PaxInstruments/t400-enclosure/graphics/front label/v1/dimensions_t400.pdf

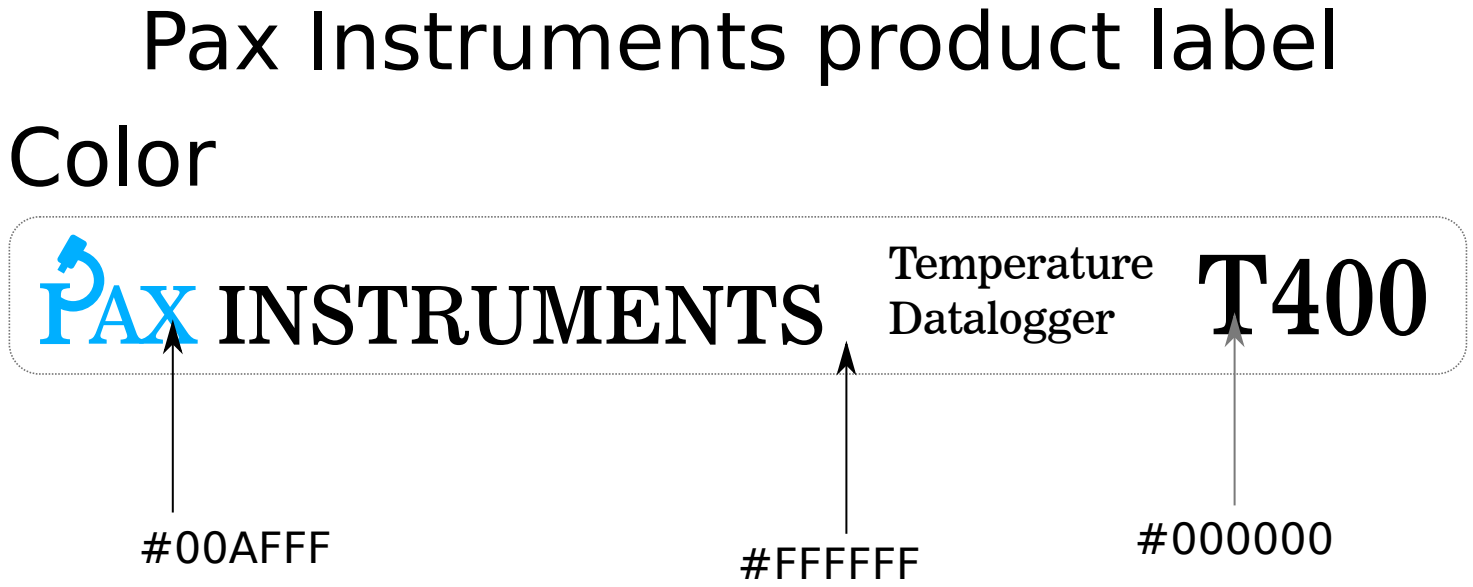
[picture p1: figure]
Pax Instruments product label; T400 Temperature AX INSTRUMENTS Datalogger; #00AFFF; #FFFFFF; Color

72mm

Dementions

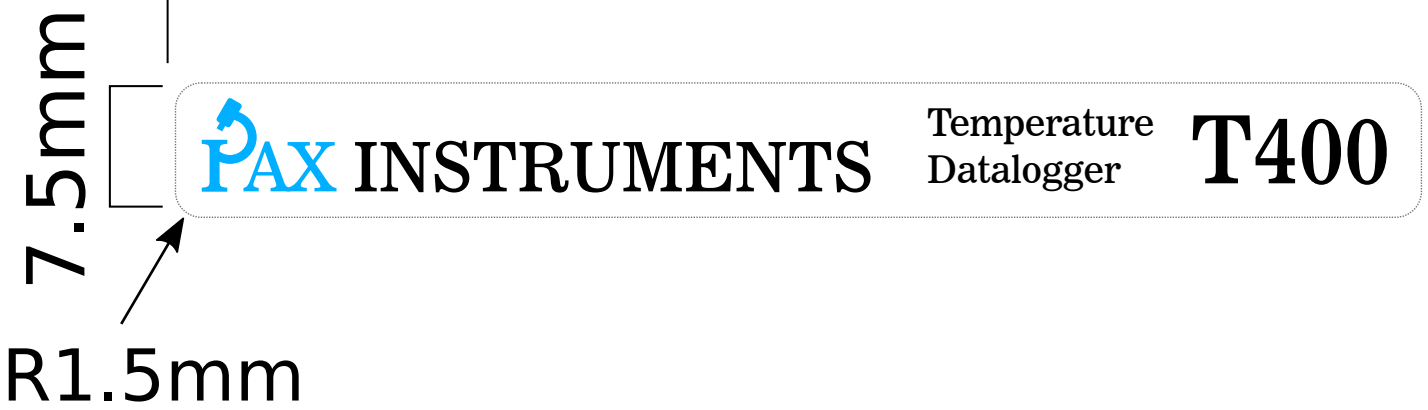
[picture p2: figure]
T400 Temperature AX INSTRUMENTS Datalogger
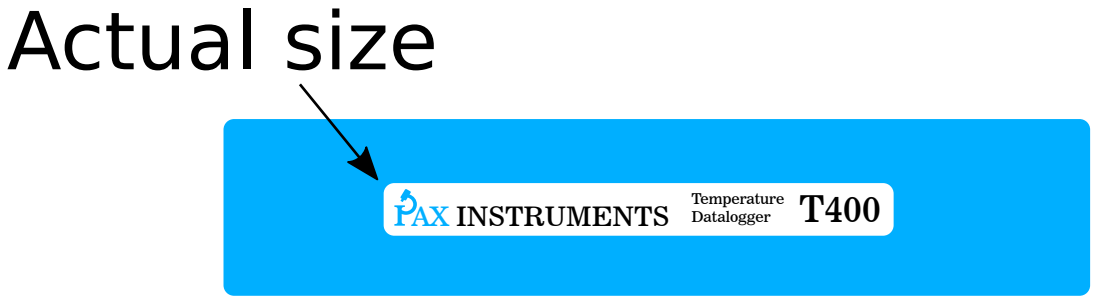
[picture p3: figure]
T400 Temperature AX INSTRUMENTS Datalogger; Actual size
