PaxInstruments/t400-enclosure/graphics/buttons/buttons_export.png

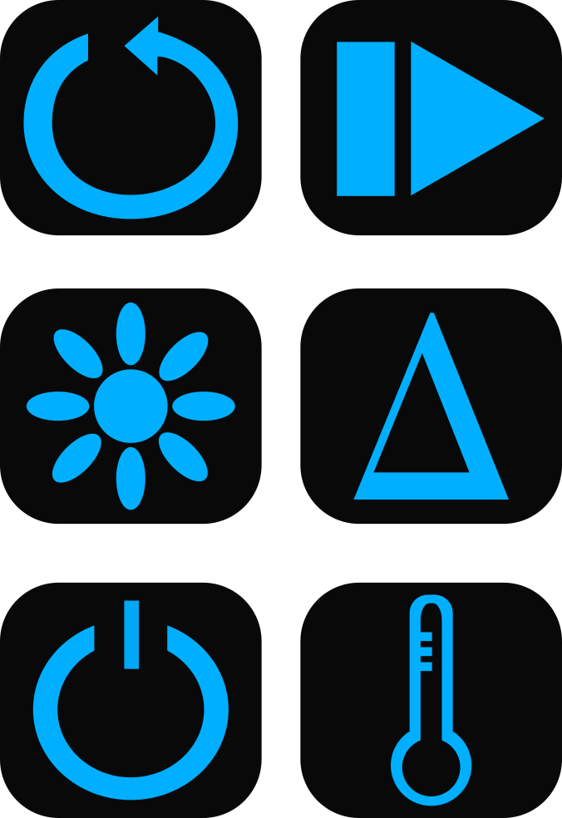
graphics/buttons/buttons_export.png
