PaxInstruments/t400-enclosure/graphics/buttons/pax_instruments_t400_button_backlight_600dpi.png

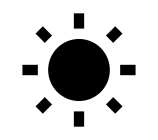
graphics/buttons/pax_instruments_t400_button_backlight_600dpi.png
