PaxInstruments/t400-enclosure/graphics/buttons/pax_instruments_t400_button_change_unit_600dpi.png

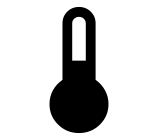
graphics/buttons/pax_instruments_t400_button_change_unit_600dpi.png
