PaxInstruments/t400-enclosure/graphics/buttons/pax_instruments_t400_button_record_600dpi.png

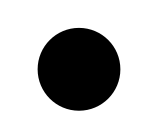
graphics/buttons/pax_instruments_t400_button_record_600dpi.png
