PaxInstruments/t400-enclosure/graphics/buttons/pax_instruments_t400_button_time_interval_600dpi.png

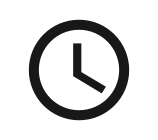
graphics/buttons/pax_instruments_t400_button_time_interval_600dpi.png
