PaxInstruments/t400-enclosure/graphics/buttons/t400-silicone-buttons-right-assembly.DXF

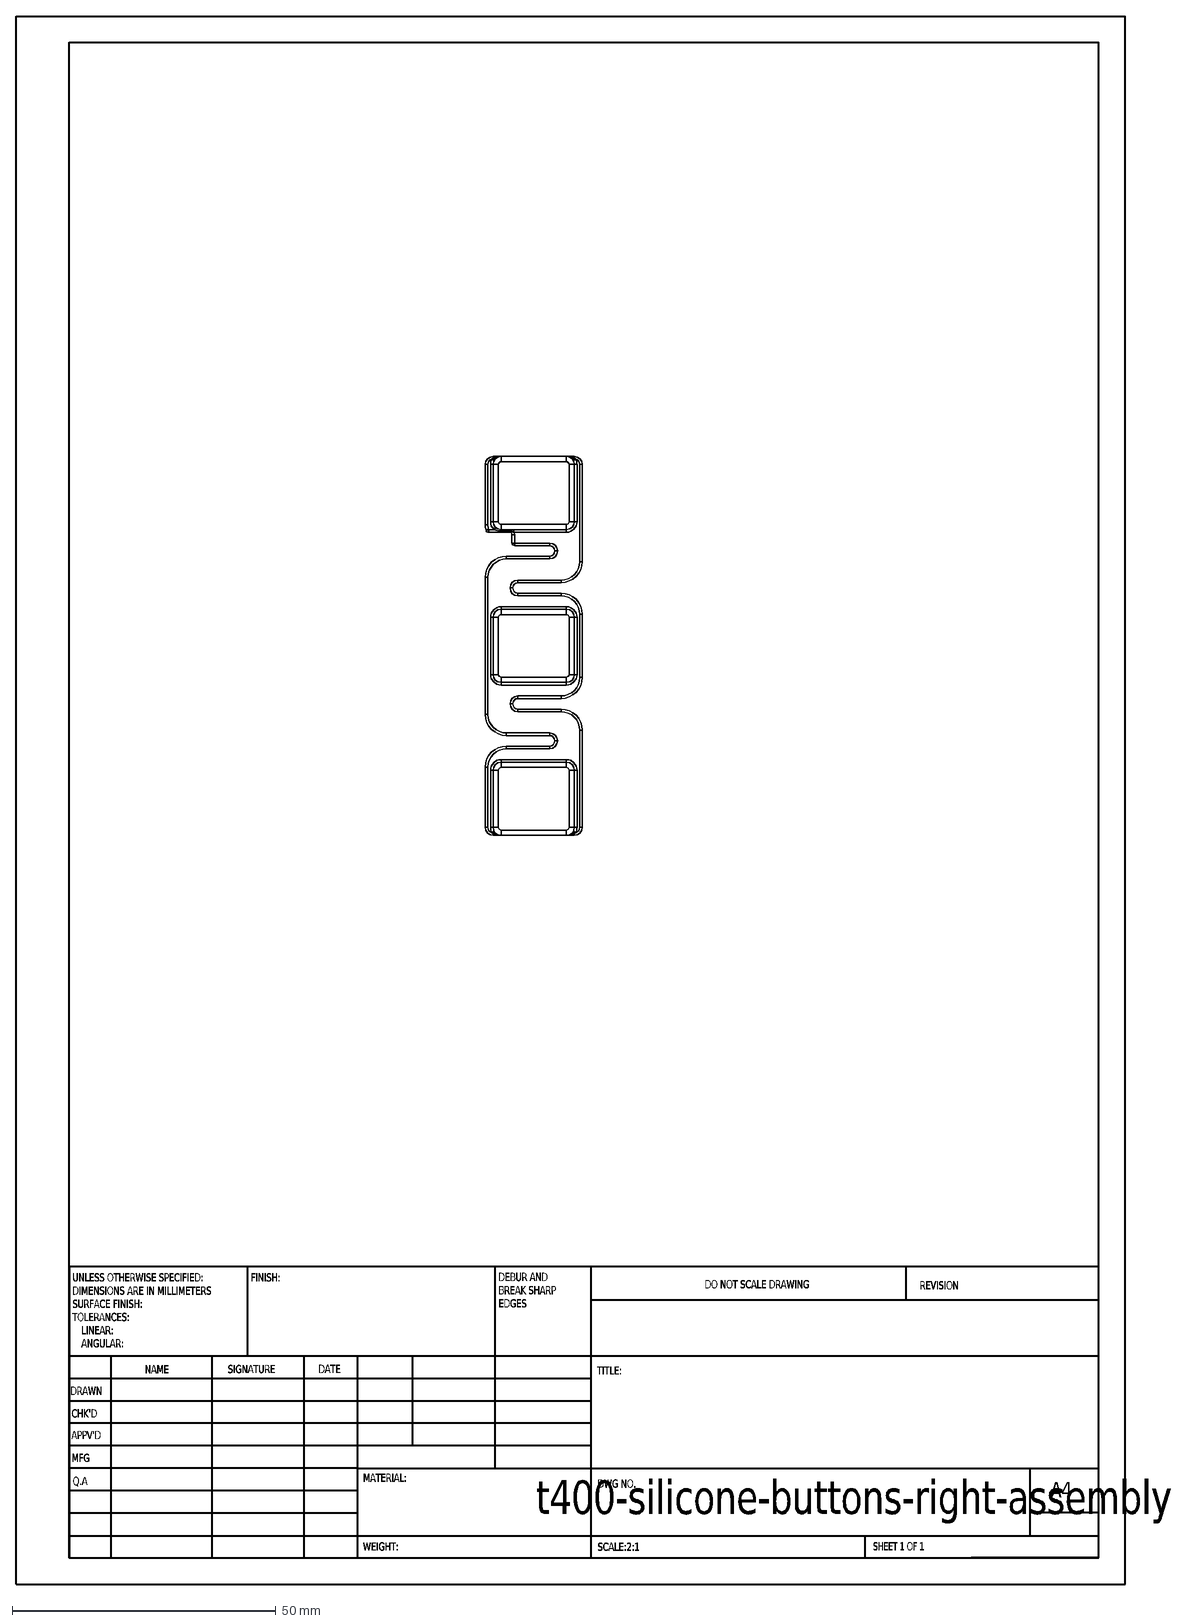
[picture p11: CAD file, 2015-04-06]
graphics/buttons/t400-silicone-buttons-right-assembly.DXF
t400-silicone-buttons-right-assembly
WEIGHT:
A4
SHEET 1 OF 1
SCALE:2:1
DWG NO.
TITLE:
REVISION
DO NOT SCALE DRAWING
MATERIAL:
DATE
SIGNATURE
NAME
DEBUR AND
BREAK SHARP
EDGES
FINISH:
UNLESS OTHERWISE SPECIFIED:
DIMENSIONS ARE IN MILLIMETERS
SURFACE FINISH:
TOLERANCES:
LINEAR:
ANGULAR:
Q.A
MFG
APPV'D
CHK'D
DRAWN
