PaxInstruments/t400-enclosure/Injection Molded/alternate bail/Assem2.SLDASM

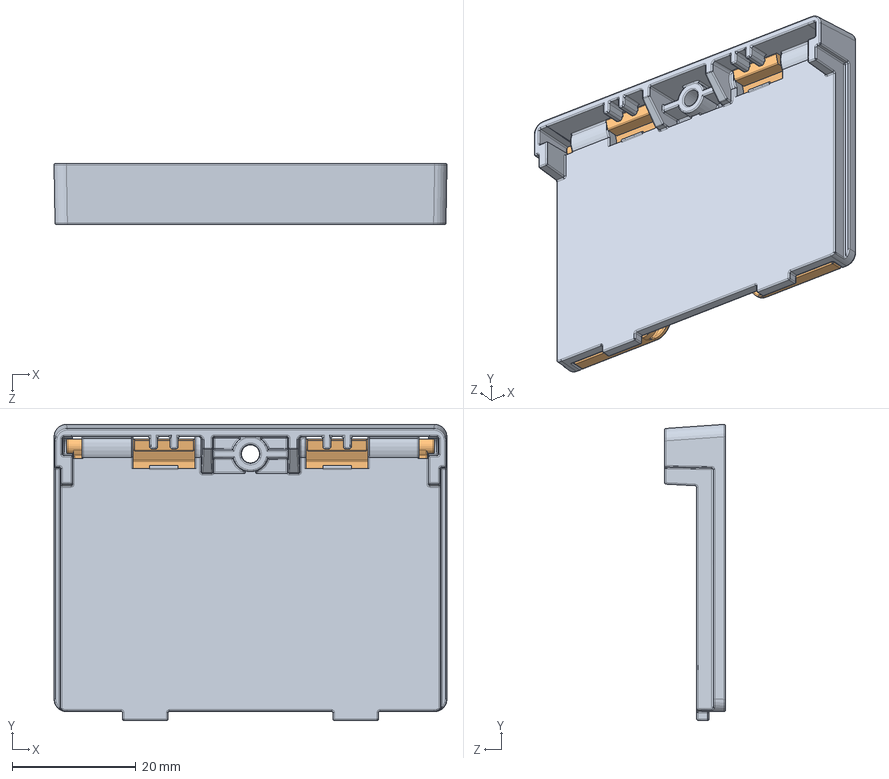
[picture p12: CAD file, 2015-08-28]
Injection Molded/alternate bail/Assem2.SLDASM
63.5 x 47.9 x 9.90 mm
t400-battery-cover-2
t400-bail-2
