PaxInstruments/t400-enclosure/Injection Molded/t400-silicone-buttons-left-assembly.SLDPRT

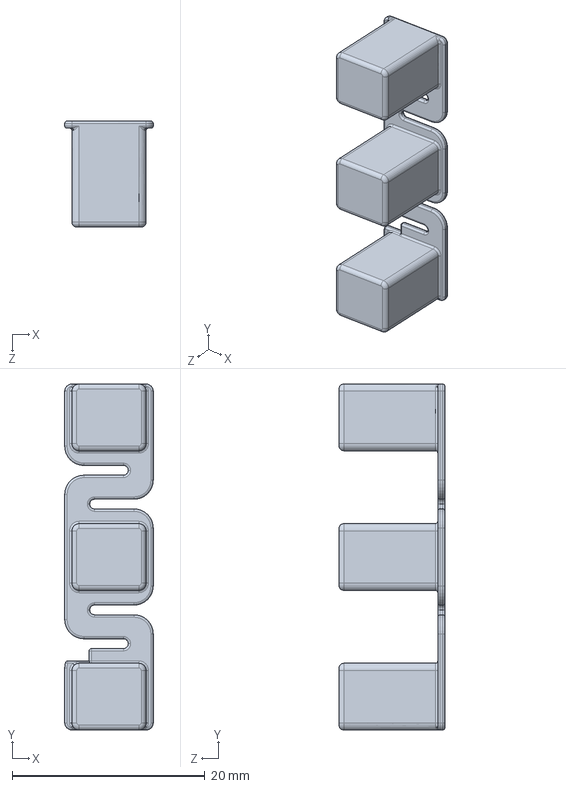
[picture p13: CAD file, 2015-11-09]
Injection Molded/t400-silicone-buttons-left-assembly.SLDPRT
9.19 x 35.9 x 11.0 mm
