PaxInstruments/t400-enclosure/Injection Molded/t400-pcba.SLDASM

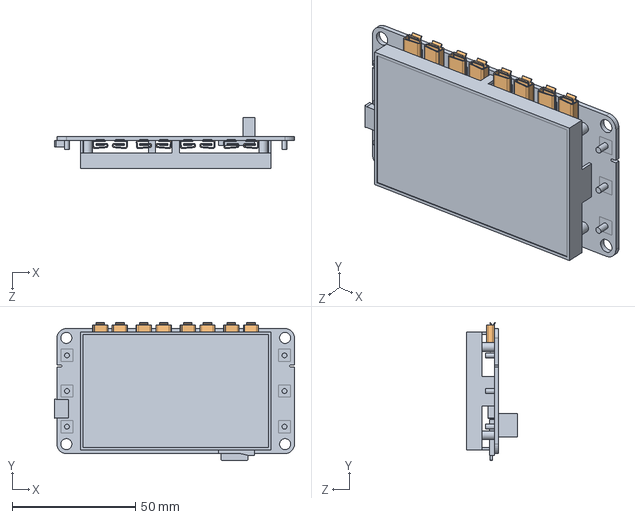
[picture p14: CAD file, 2015-11-09]
Injection Molded/t400-pcba.SLDASM
97.5 x 56.2 x 20.5 mm
t400-pcb
t400-thermo-clip2 x 8
