PaxInstruments/t400-enclosure/Injection Molded/t400-assembled.SLDASM

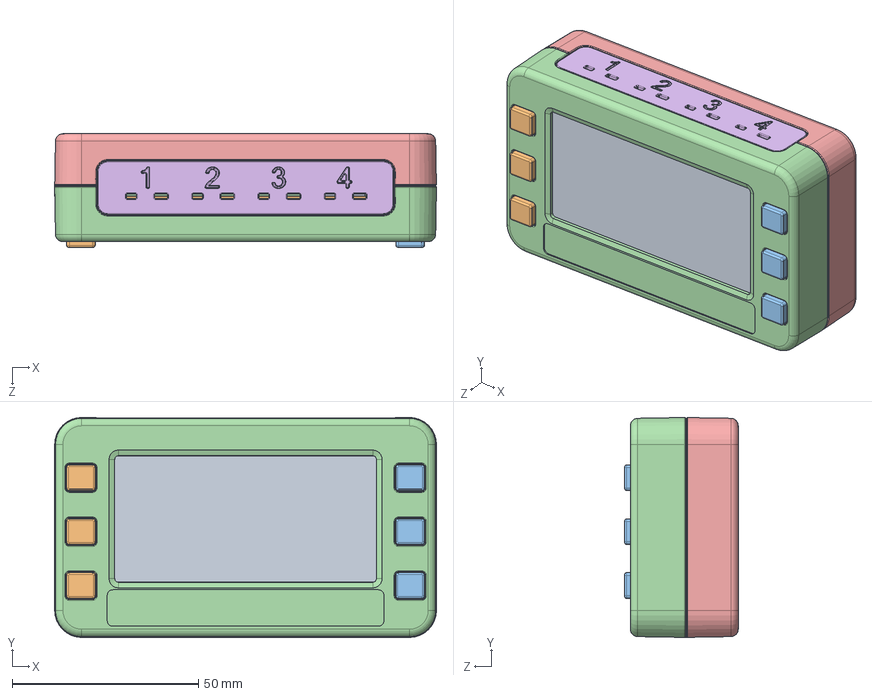
[picture p15: CAD file, 2015-10-15]
Injection Molded/t400-assembled.SLDASM
102.6 x 59.1 x 30.5 mm
t400-pcb
t400-thermo-clip2 x 8
t400-front
t400-back
t400-top
t400-battery-cover
t400-bail
