PaxInstruments/t400-enclosure/3D Printed/t400-enclosure.sldprt

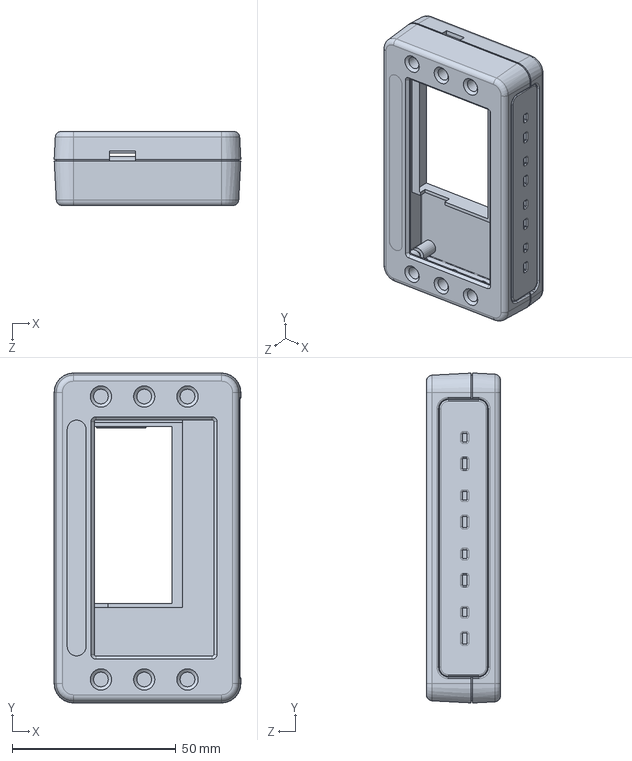
[picture p16: CAD file, 2014-09-01]
3D Printed/t400-enclosure.sldprt
57.0 x 100.7 x 22.7 mm
