PaxInstruments/t400-enclosure/graphics/front label/v2/t400-front-label-v2.dxf

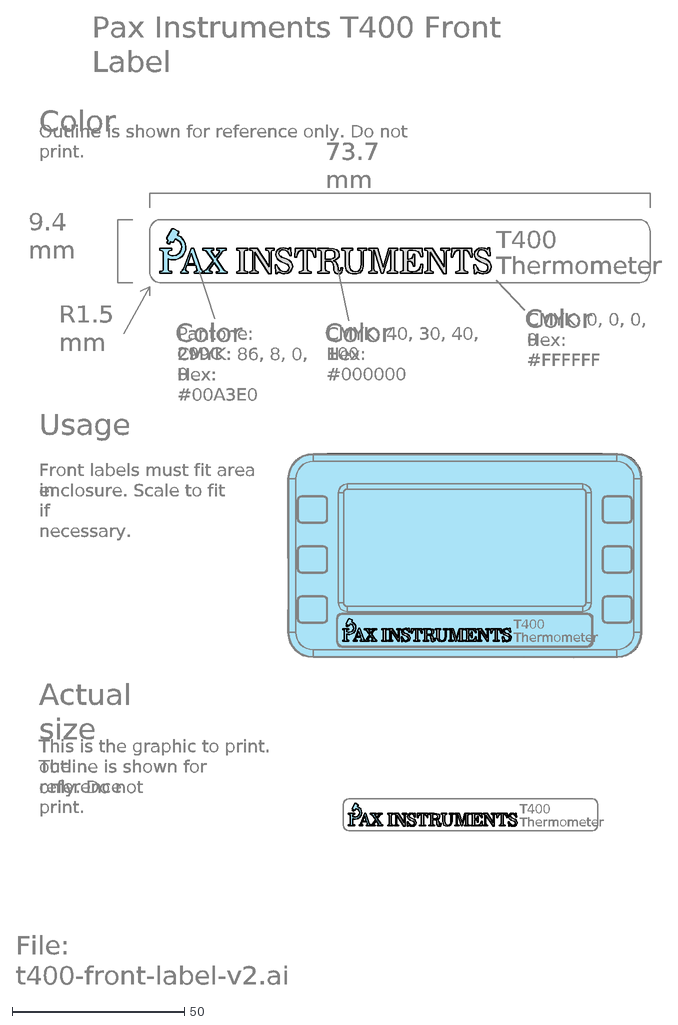
[picture p17: CAD file, 2015-12-21]
graphics/front label/v2/t400-front-label-v2.dxf
Usage
Pax Instruments T400 Front Label
File: t400-front-label-v2.ai
T400
Thermometer
73.7 mm
9.4 mm
R1.5 mm
Color
Pantone: 299C
CMYK: 86, 8, 0, 0
Hex: #00A3E0
CMYK: 40, 30, 40, 100
Hex: #000000
CMYK: 0, 0, 0, 0
Hex: #FFFFFF
Actual size
Front labels must fit area in
enclosure. Scale to fit if
necessary.
This is the graphic to print. The
outline is shown for reference
only. Do not print.
Outline is shown for reference only. Do not print.
