PaxInstruments/t400-enclosure/graphics/pi_logos/logo.dxf

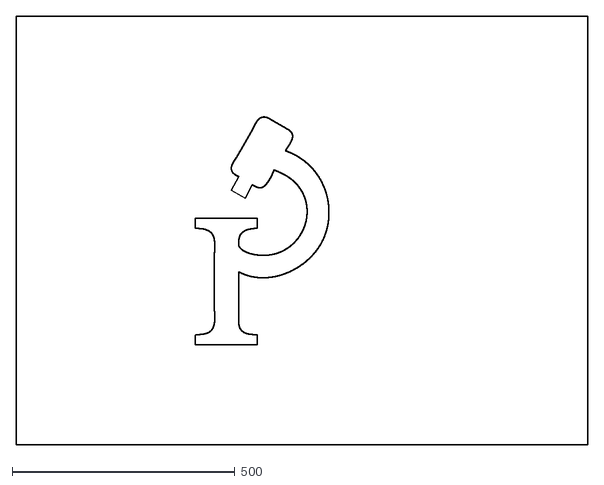
[picture p18: CAD file, 2015-01-30]
graphics/pi_logos/logo.dxf
1284.0 x 964.0
