PaxInstruments/t400-enclosure/Injection Molded/alternate bail/t400-bail-2.sldprt

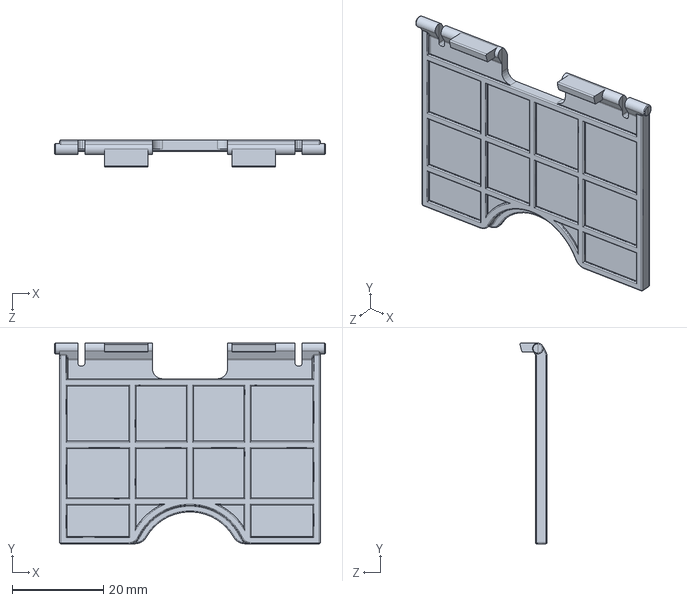
[picture p19: CAD file, 2015-08-28]
Injection Molded/alternate bail/t400-bail-2.sldprt
59.5 x 44.1 x 5.95 mm
