PaxInstruments/t400-enclosure/Injection Molded/t400-window.sldprt

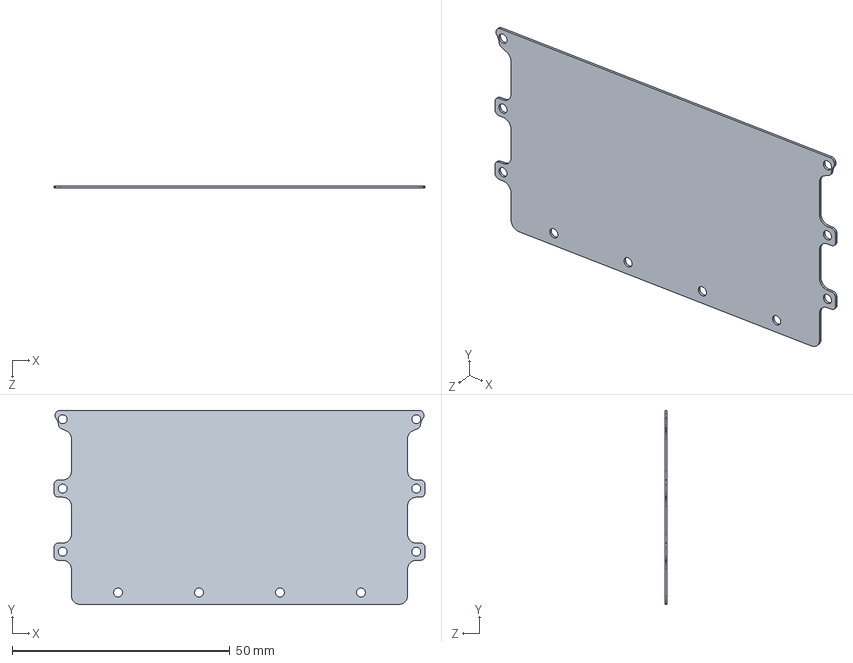
[picture p20: CAD file, 2015-12-19]
Injection Molded/t400-window.sldprt
85.1 x 44.5 x 0.5 mm
