PaxInstruments/t400-enclosure/3D Printed/t400-enclosure-back.sldprt

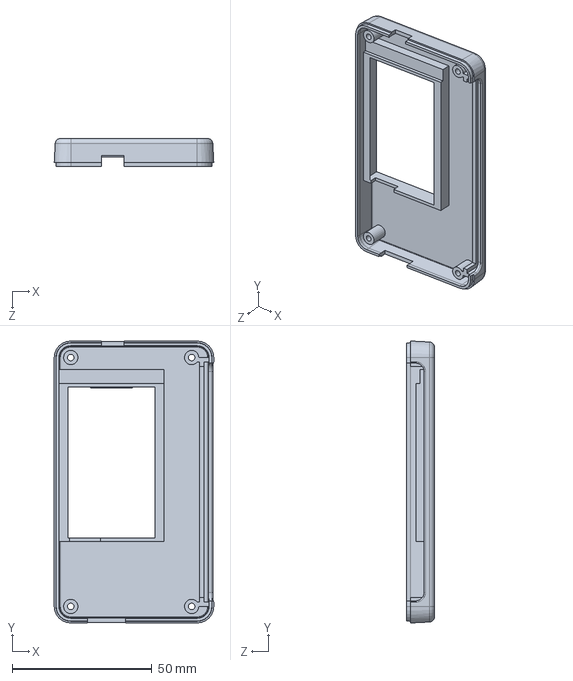
[picture p21: CAD file, 2014-09-01]
3D Printed/t400-enclosure-back.sldprt
57.0 x 100.7 x 10.0 mm
