PaxInstruments/t400-enclosure/graphics/front label/v2/t400-front.DXF

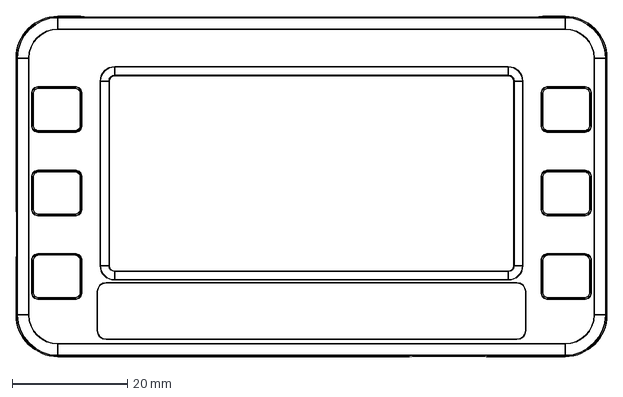
[picture p22: CAD file, 2015-12-21]
graphics/front label/v2/t400-front.DXF
102.5 x 59.1 mm
