PaxInstruments/t400-enclosure/Injection Molded/t400-BL5C-battery.sldprt

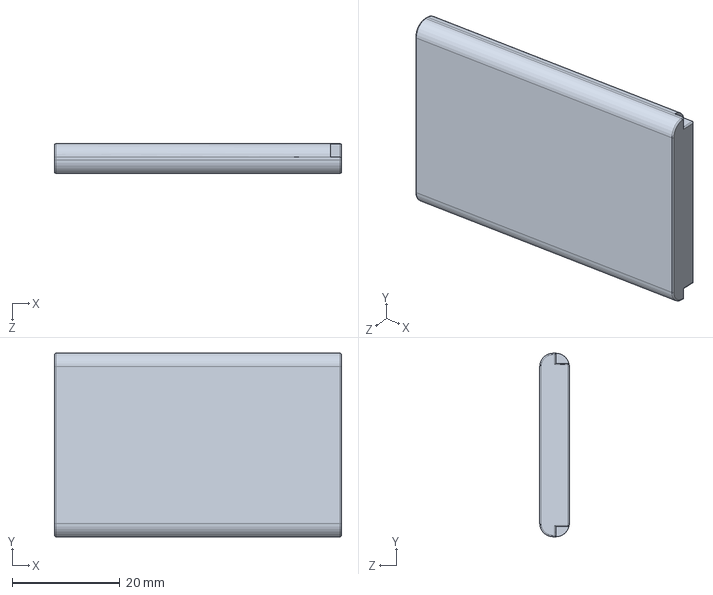
[picture p23: CAD file, 2015-11-09]
Injection Molded/t400-BL5C-battery.sldprt
53.2 x 34.0 x 5.50 mm
