PaxInstruments/t400-enclosure/3D Printed/t400-enclosure-tc-panel.sldprt

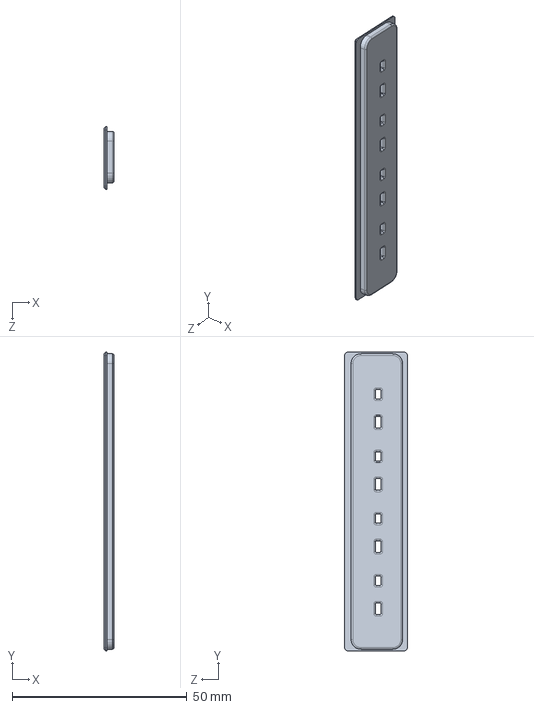
[picture p24: CAD file, 2014-09-01]
3D Printed/t400-enclosure-tc-panel.sldprt
2.87 x 85.5 x 18.0 mm
