PaxInstruments/t400-enclosure/Injection Molded/alternate bail/t400-battery-cover-2.SLDPRT

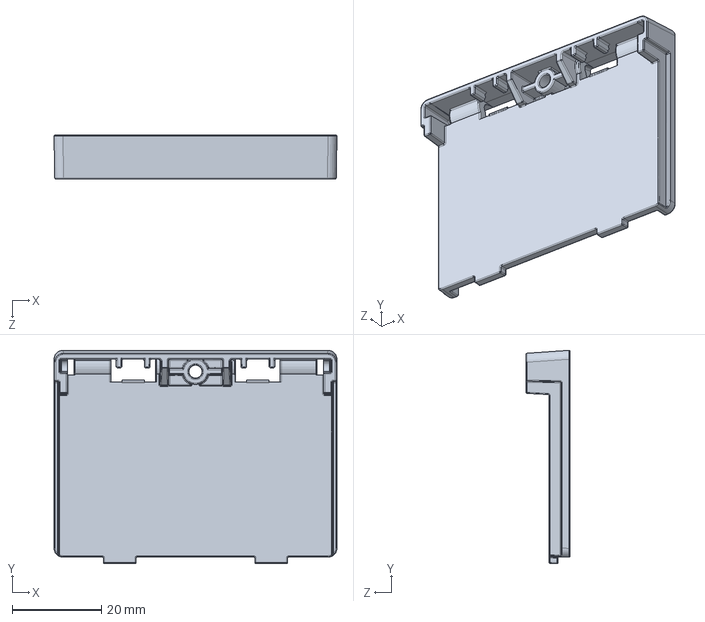
[picture p25: CAD file, 2015-08-28]
Injection Molded/alternate bail/t400-battery-cover-2.SLDPRT
63.5 x 47.9 x 9.90 mm
