PaxInstruments/t400-enclosure/3D Printed/t400-enclosure-front.sldprt

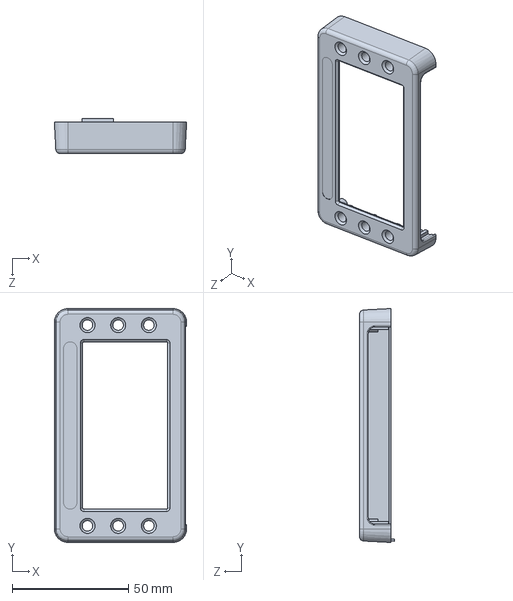
[picture p26: CAD file, 2014-09-01]
3D Printed/t400-enclosure-front.sldprt
57.0 x 100.7 x 15.1 mm
