PaxInstruments/t400-enclosure/3D Printed/t400-buttons.sldprt

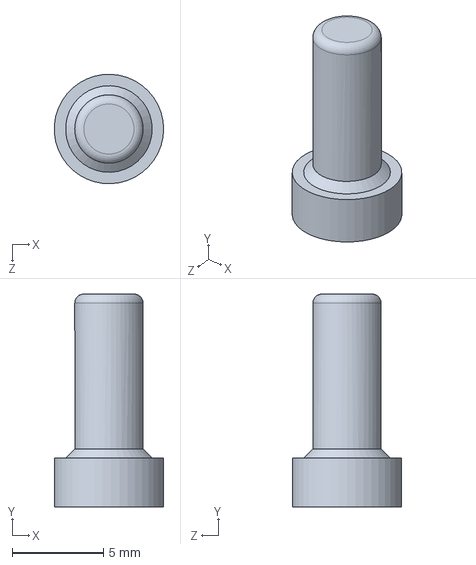
[picture p27: CAD file, 2014-08-26]
3D Printed/t400-buttons.sldprt
5.99 x 11.7 x 6.00 mm
