PaxInstruments/t400-enclosure/Injection Molded/t400-pcb.sldprt

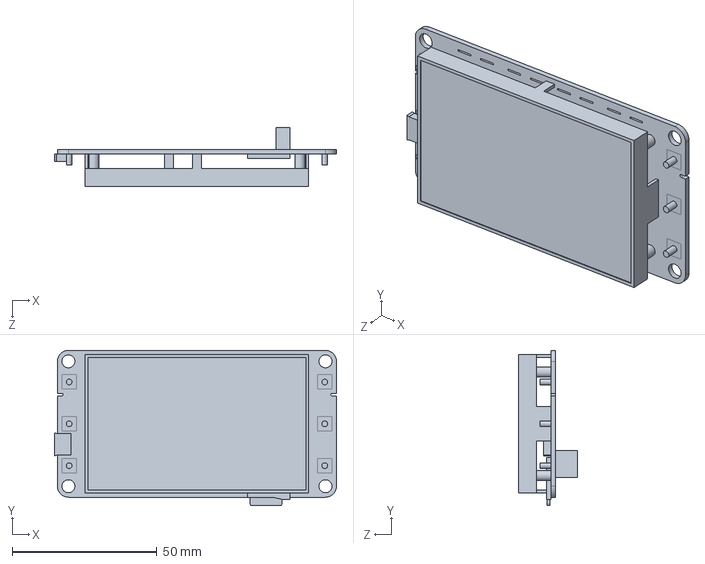
[picture p28: CAD file, 2015-11-09]
Injection Molded/t400-pcb.sldprt
97.5 x 53.7 x 20.5 mm
