PaxInstruments/t400-enclosure/Injection Molded/t400-top.sldprt

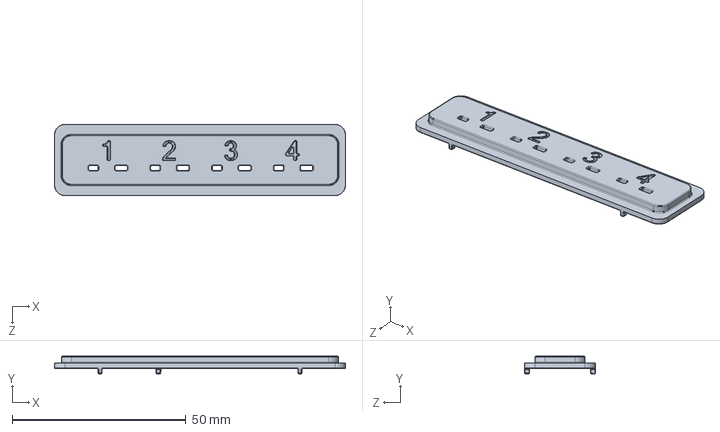
[picture p29: CAD file, 2015-10-15]
Injection Molded/t400-top.sldprt
83.7 x 5.10 x 20.5 mm
