PaxInstruments/t400-enclosure/Injection Molded/t400-battery-cover.sldprt

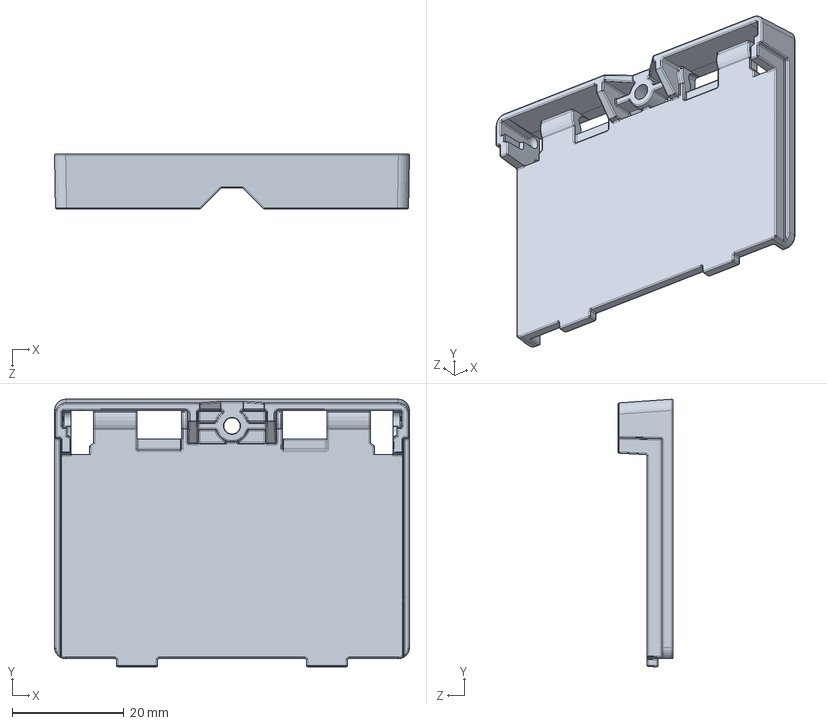
[picture p30: CAD file, 2015-10-15]
Injection Molded/t400-battery-cover.sldprt
63.5 x 47.9 x 9.90 mm
