PaxInstruments/t400-enclosure/Injection Molded/t400-bail.sldprt

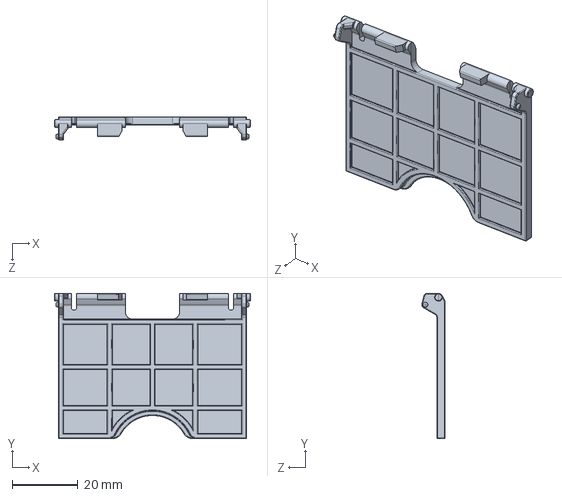
[picture p31: CAD file, 2015-10-15]
Injection Molded/t400-bail.sldprt
59.5 x 44.1 x 7.09 mm
