PaxInstruments/t400-enclosure/Injection Molded/t400-back.sldprt

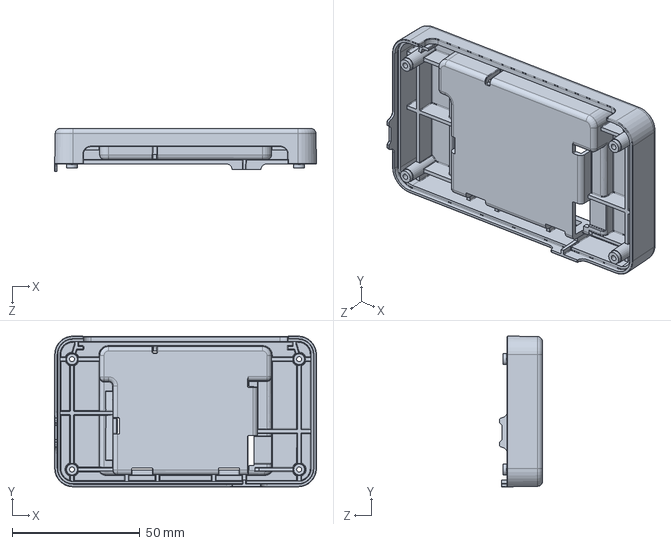
[picture p32: CAD file, 2015-10-15]
Injection Molded/t400-back.sldprt
102.5 x 59.1 x 16.9 mm
