PaxInstruments/t400-enclosure/Injection Molded/t400-label-front.SLDPRT

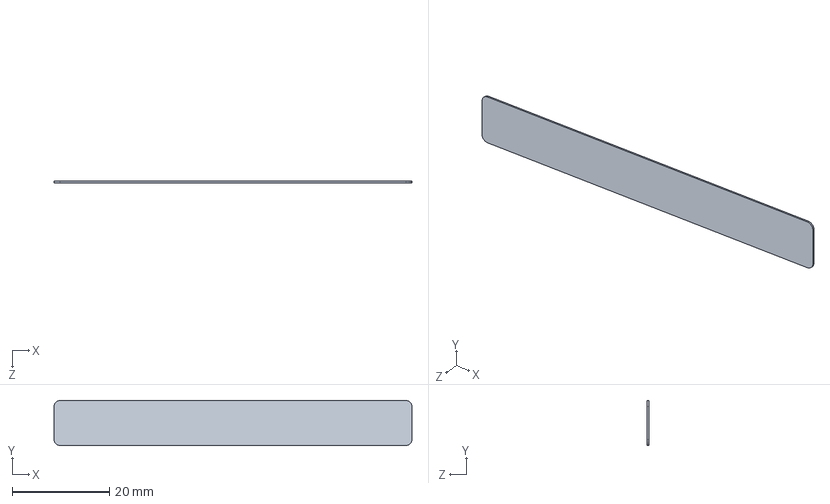
[picture p33: CAD file, 2015-10-10]
Injection Molded/t400-label-front.SLDPRT
73.8 x 9.30 x 0.32 mm
