PaxInstruments/t400-enclosure/Injection Molded/t400-thermo-clip2.SLDPRT

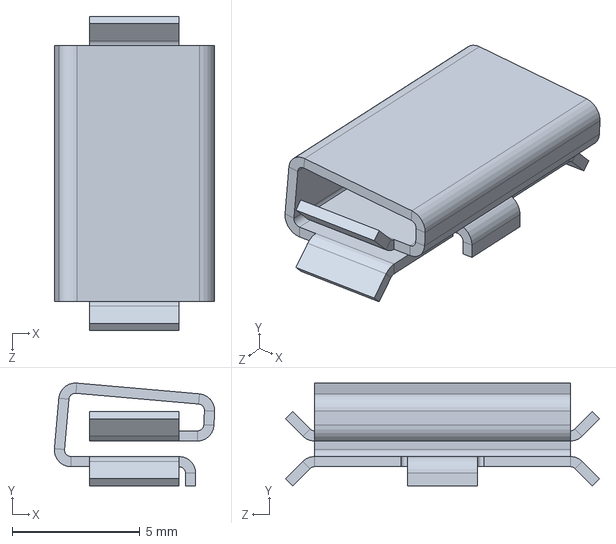
[picture p34: CAD file, 2015-08-11]
Injection Molded/t400-thermo-clip2.SLDPRT
6.26 x 4.02 x 12.3 mm
