PaxInstruments/t400-enclosure/Injection Molded/t400-thermo-clip2_pax.SLDPRT

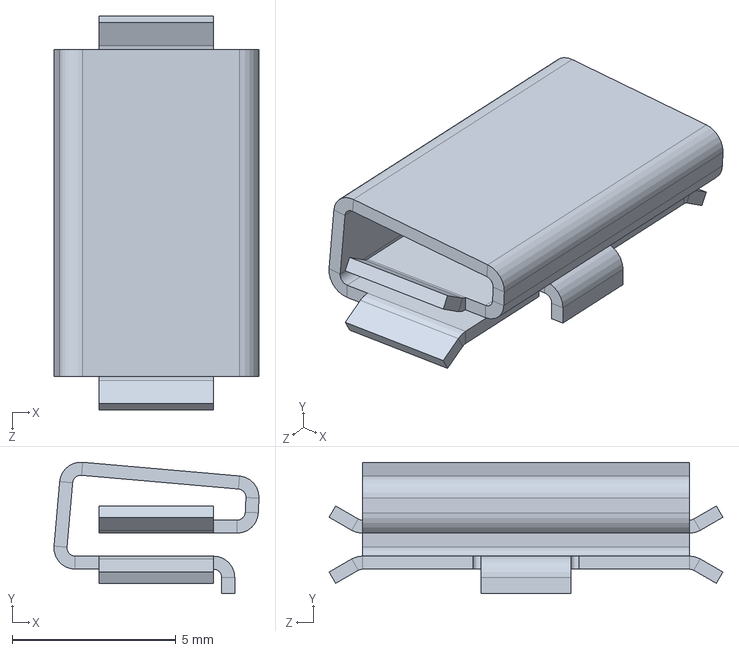
[picture p35: CAD file, 2015-04-29]
Injection Molded/t400-thermo-clip2_pax.SLDPRT
6.26 x 4.02 x 12.0 mm
