PaxInstruments/t400-enclosure/Injection Molded/t400-front.sldprt

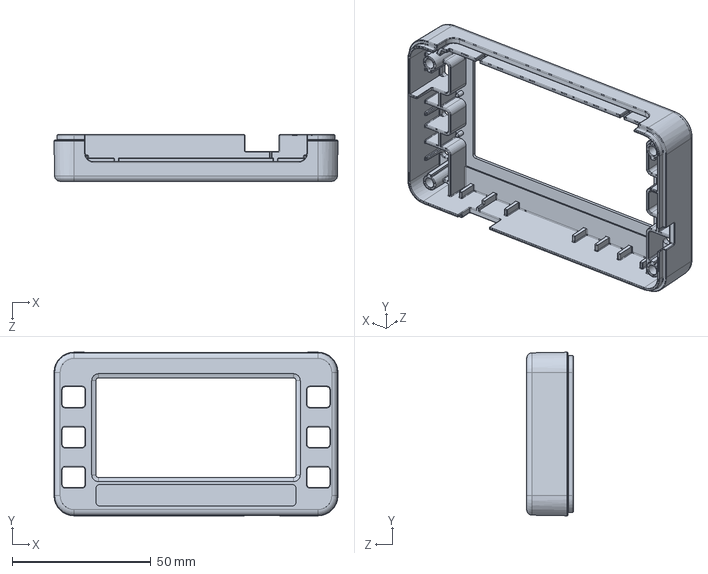
[picture p36: CAD file, 2015-04-06]
Injection Molded/t400-front.sldprt
102.5 x 59.1 x 16.9 mm
