PaxInstruments/t400-enclosure/Injection Molded/t400-thermo-clip.SLDPRT

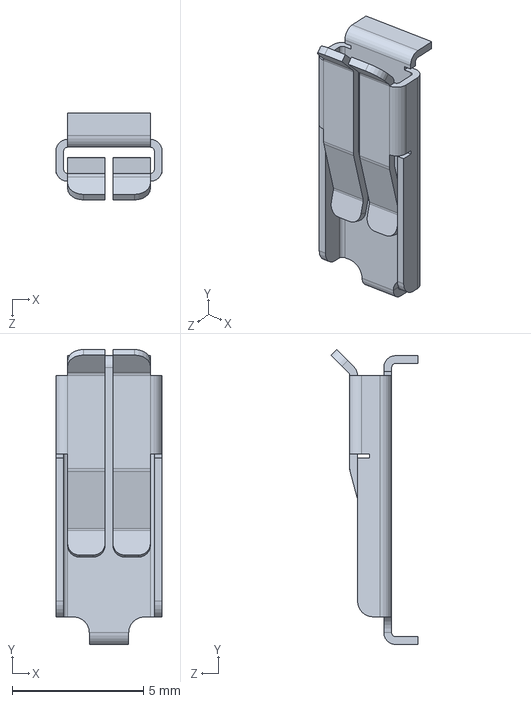
[picture p37: CAD file, 2015-03-23]
Injection Molded/t400-thermo-clip.SLDPRT
4.05 x 11.2 x 3.31 mm
