PaxInstruments/t400-enclosure/Injection Molded/t400-fastener-threaded-insert.SLDPRT

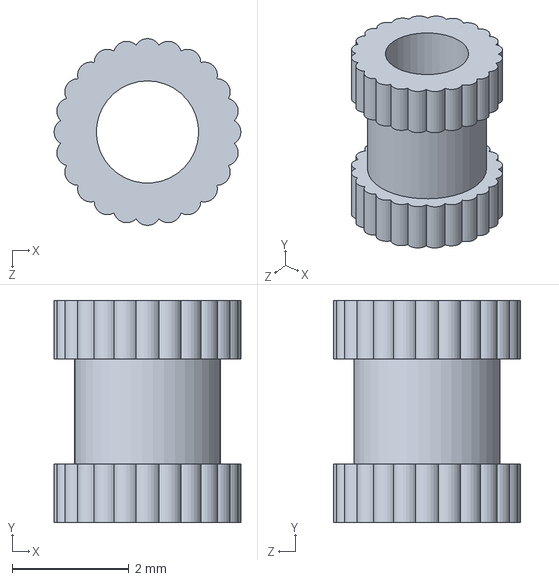
[picture p38: CAD file, 2015-01-30]
Injection Molded/t400-fastener-threaded-insert.SLDPRT
3.20 x 3.80 x 3.20 mm
