PaxInstruments/t400-enclosure/Injection Molded/t400-fastener-m2x10.SLDPRT

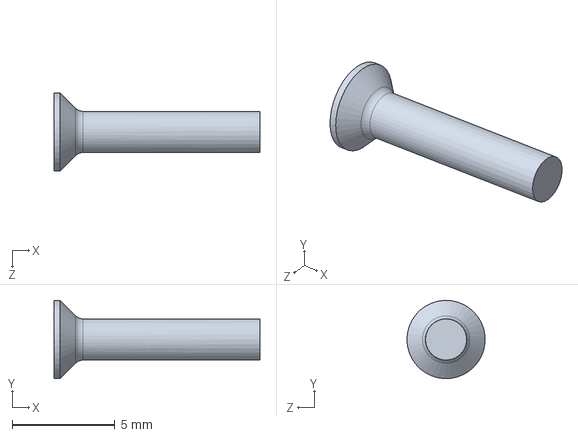
[picture p39: CAD file, 2015-01-30]
Injection Molded/t400-fastener-m2x10.SLDPRT
10.0 x 3.80 x 3.79 mm
