PaxInstruments/t400-enclosure/Injection Molded/t400-fastener-m2x24.SLDPRT

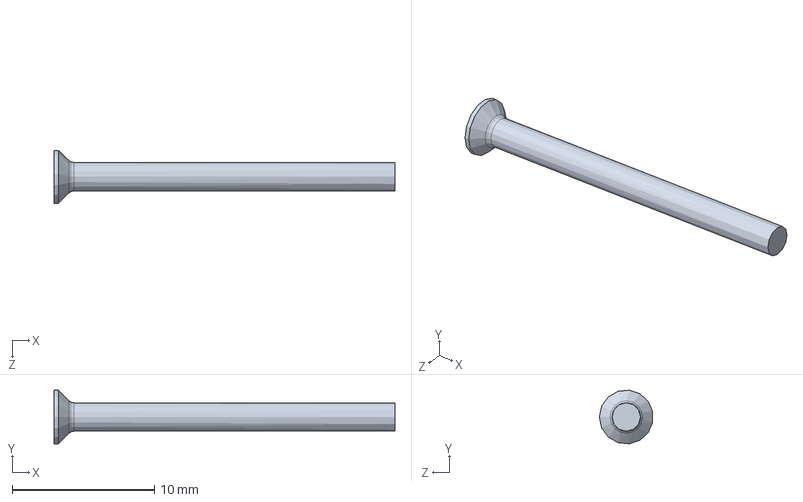
[picture p40: CAD file, 2015-01-30]
Injection Molded/t400-fastener-m2x24.SLDPRT
24.0 x 3.78 x 3.76 mm
