PaxInstruments/t400-enclosure/(list of files, cad)

Other CAD files:
Injection Molded/t400-silicone-buttons-right-assembly.SLDPRT
Injection Molded/t400-silicone-buttons.sldprt
3D Printed/t400-enclosure-back.STL
3D Printed/t400-enclosure-front.STL
3D Printed/t400-enclosure-tc-panel.STL
Injection Molded/makeProjectedPlanarWire.x_t
Injection Molded/t400-label-front.DXF
Injection Molded/t400-label-front.SLDDRW
Injection Molded/t400-thermo-clip2_pax.DXF
Injection Molded/t400-thermo-clip2_pax.SLDDRW
Injection Molded/t400-window.DXF
Injection Molded/t400-window.SLDDRW
