PaxInstruments/t400-enclosure/(threads)

Thread 6 (2014-08-25):

Design a wall-mount clip

charlespax, 2014-08-25:
Mount the clip to a wall. The T400 snaps right in.

charlespax, 2015-01-23:
Beyond the scope of the T400. Moving to Enclosure version :-)

charlespax, 2015-08-08:
This would be a different product. Closing issue.

Closed 2015-08-08.

Thread 7 (2014-08-25):

Quick reference documentation

charlespax, 2014-08-25:
Make a quick reference documentation sticker for the back of the enclosure.

charlespax, 2015-01-23:
We don't need this. Moving to Enclosure version :-)

charlespax, 2015-08-08:
Will not do. Closing issue.

Closed 2015-08-08.

Thread 11 (2014-09-01):

Does the enclosure need shielding?

charlespax, 2014-09-01:
Maybe a good questions for the electronics.

charlespax, 2015-01-23:
We don't know at this point and we aren't going to find out. Moving to Enclosure version :-)

charlespax, 2015-08-08:
Will not do in this product. Closing issue.

Closed 2015-08-08.

Thread 16 (2014-12-11):

Should the TC number be embossed or debossed?

charlespax, 2014-12-11:
Will this matter for manufacturing? Which one will look better? Do we have example from other products from which we can take inspiration?

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

starno, 2015-01-22:
There are multiple places with debossing on this enclosure and it generally seems beneficial for our application.  Im going to close this issue

Closed 2015-01-22.

Thread 19 (2014-12-11):

Top panel design

charlespax, 2014-12-11:
We have the option to put some useful information onto the top panel. Maybe marking the positive and negative ends of the connectors.

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

This is the Fluke 54 II B. I like the safety warning.
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

starno, 2015-01-16:
Any more details to add here before closing the issue?  The only thing that has changed from the last photo is that the positive and negative holes are different sizes to prevent backwards insertion

charlespax, 2015-01-16:
Can you do a quick test with a thermocouple connector to verify it can't be plugged in backwards? I think I tested that, but can't remember. If we're good there, we can close it.

starno, 2015-01-16:
Yeah, it checks out

Closed 2015-01-16.

Thread 22 (2014-12-11):

Gap between PCB and enclosure

charlespax, 2014-12-11:
It would be good to have a larger gap between the PCB and enclosure, so the enclosure can be used with a double sided design.

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

starno, 2015-01-23:
@charlespax can you give me the height and width of the new connector?  The height of the leaf spring contacts too.

charlespax, 2015-01-25:
Height: 6.86 mm. Width: 9.52 mm (should be the same). Leaf spring contact height: .74 mm.

starno, 2015-01-26:
it seems the numbers on the connector represent the height. 6 8 for 6.8mm and 7 7 for 7.7mm

starno, 2015-01-30:
2mm all over the backside

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

Closed 2015-01-30.

Thread 24 (2014-12-11):

Battery information

charlespax, 2014-12-11:
Maybe have something in this area indicating what type of battery the device takes.
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

charlespax, 2015-01-01:
Probably just BL-5C.

starno, 2015-01-16:
This is what the battery info looks like

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

charlespax, 2015-01-16:
Looks good to me.

Closed 2015-01-16.

Thread 29 (2014-12-15):

Add punchouts for 2x3 pin headers

charlespax, 2014-12-15:
In electronics issue https://github.com/PaxInstruments/t400-electronics/issues/86#issuecomment-66986560 the two 2x3 pin headers will likely be moved to locations such that they can be accessed through a hole in the back of the enclosure. This is a nice-to-have feature and should not compromise any other features.

Here is the proposed punchout areas.
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

A closeup with dimensions and location. The other punchout would be mirrored on the other side.
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

charlespax, 2015-01-03:
The cutouts are in Enclosure version 0.9, so we should close this. https://github.com/PaxInstruments/t400-electronics/issues/97 is still open though.

Closed 2015-01-03.

Thread 32 (2014-12-19):

Battery cover gap

charlespax, 2014-12-19:
In the Enclosure version 0.1 (SLA) print there is a fairly large gap between the battery cover and the back of the enclosure. When the battery cover is pushed into the upper left corner...
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
we get this gap in the bottom right.
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

starno, 2015-01-22:
Gap closed to 0.19mm down from 0.5mm.  It should feel pretty snug

![Uploading Capture.PNG . . .]()

Closed 2015-01-22.

Thread 33 (2014-12-19):

Battery notch

charlespax, 2014-12-19:
In the Enclosure version 0.1 (SLA) print the space the battery slides into seems too small. When installing the battery I need to wedge the battery between the notch and enclosure. The image below shows the area I'm talking about. I don't know if this is the model or the print. I believe the battery should go in more smoothly.
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

starno, 2015-01-16:
Turns out there wasn't any clearance between these two surfaces which explains why it was tight.  Clearance added.

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

Closed 2015-01-16.

Thread 34 (2014-12-19):

Floppy top panel

charlespax, 2014-12-19:
In the Enclosure version 0.1 (SLA) print the top panel flops around a bit when placed in one side of the enclosure. When the enclosure is fully assembled there is slight movement, but nothing that would cause a problem.

For production it would be good to have the panel be more erect. This would aid in installing the back of the enclosure.

Side view:
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

Close up view?
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

Top view:
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

starno, 2015-01-16:
I tightened up that gap so that there is not much wiggle room even after the drafting.  The wall that supports the underside of the top also got taller and I made the top sit deeper into the groove so that it is wont tip back nearly as much during installation.

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

Closed 2015-01-16.

Thread 35 (2014-12-19):

Top panel PCB support

charlespax, 2014-12-19:
The slots for the top panel can probably be a bit smaller. The image below shows the gap when a 1.6 mm PCB is in the slot. We want the enclosure to support using custom PCBs for the top panel, which is true for the current design, but be a little less floppy. However, we should not compromise the enclosure integrity just to make a PCB top panel a bit less floppy.

Is there a technical reason for having the top panel be a thick as it is or can that be a bit smaller?

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

starno, 2015-01-16:
This is fixed with along with issue #34

Closed 2015-01-16.

Thread 36 (2014-12-19):

SLA print strangeness

charlespax, 2014-12-19:
The Enclosure version 0.1 (SLA) print has a strange feature on it. The area shown in the image below seems to be made of two polygons that are not coplanar. I can feel the difference when I touch it. There is nothing strange in the model though.
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

starno, 2015-01-16:
That is strange.  Might be an STL artifact.  Since there is nothing that needs to be changed, Im going to close this

Closed 2015-01-16.

Thread 37 (2014-12-19):

LCD constraint at bottom

charlespax, 2014-12-19:
In the Enclosure version 0.1 (SLA) print there is a large gap between the LCD and enclosure at the bottom. I think these ribs should be extended to constrain the LCD.
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

The same gap exists int he model.
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

starno, 2015-01-16:
I closed up the gap as far as I could, because the fillets on the bottom of the ribs would interfere.  I also just noticed the logo detent is a thin section so we might have to shift everything back to compensate

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

charlespax, 2015-01-23:
This should be fully addressed for Enclosure version 0.2 (SLA).

Do we need drafting on that edge? We should be able to get away with small sections not being drafted.

Does that corner need to be filleted?

starno, 2015-01-26:
Fillet removed and the gap is closed in (Now 0.14mm from LCD)  Should be nice and snug

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

charlespax, 2015-01-26:
Mmm... looks very cozy.

Closed 2015-01-26.

Thread 39 (2014-12-19):

Threaded insert geometry

charlespax, 2014-12-19:
In the Enclosure version 0.1 (SLA) print the holes for the threaded inserts to not match the threaded inserts I have. I have not tested with the new threaded inserts, so there is no indication of a problem. I just want to give a sense of the size and bring attention to an inconsistency: the geometry for the enclosure threaded inserts and the one battery cover insert do not match.

Here is one of the four enclosure standoffs. You can see the threaded insert rests right inside the hole.
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

For the battery cover, however, the threaded insert does not fit at all.
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

 I tried to widen the hole then push the threaded insert in with a soldering iron. Whoops!
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

charlespax, 2015-01-23:
@starno is this resolved?

starno, 2015-01-24:
This is resolved.  All the threaded insert locations are made to fit the M2 3.2x5mm inserts

Closed 2015-01-24.

Thread 41 (2014-12-19):

Enclosure gap

charlespax, 2014-12-19:
In the Enclosure version 0.1 (SLA) print there seems to be a bit of a gap between the two enclosure halves. There is a gap modeled in. Is there a technical reason for this? Right now the enclosure feels a bit janky.

I believe when the enclosure experiences torsion the stress will be transferred to the screws and threaded inserts because the two halves of the enclosure are not fully engaged with each other.

When I push the two halves in different directions, this is the maximum gap:
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

The model:
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

starno, 2015-01-16:
The space between the two is 0.14mm down from 0.27mm.  I also changed the vertical spacing between them so that they dont bottom out anymore.   Since we originally intended the PCB to be pinched between the front and back, the bosses on the front and back are now the only points that contact.

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

Closed 2015-01-16.

Thread 42 (2014-12-19):

Tilting bail size mismatch

charlespax, 2014-12-19:
When putting together the Enclosure version 0.1 (SLA) print I was unable to put on the tilting bail. Upon closer inspection I noticed that the hinge was larger than the space it has to pass through. Looking at the model I see that I have to pass a 6.51 mm hinge through a 6.32 mm space. I cut off the protrusion to assemble the print, but this should be fixed.

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

starno, 2015-01-16:
The new bail design avoids this problem all together

Closed 2015-01-16.

Thread 44 (2014-12-21):

Enclosure version 0.1 (SLA) results

charlespax, 2014-12-21:
The Enclosure version 0.1 (SLA) prints look pretty good. There are few issues that may be due to the printing or the model. These are mentioned in other Github issues. Below is a series of photographs of the Enclosure version 0.1 (SLA) prints.

(The buttons are inset because the PCB does not have switches installed.)
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

Front exterior
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

Front interior
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

Back exterior
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

Back interior
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

Top panel exterior (circle is reference to https://github.com/PaxInstruments/t400-enclosure/issues/43)
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

Top panel interior
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

Battery cover exterior
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

Battery cover interior
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

Tilting bail exterior
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

Tilting bail interior
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

Keypad
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

Here is how the tilting bail and battery cover match up
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

After modification (https://github.com/PaxInstruments/t400-enclosure/issues/42) they snap together
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

starno, 2015-01-22:
looks good, but 0.2 will be better

Closed 2015-01-22.

Thread 46 (2014-12-21):

Tilt angle

charlespax, 2014-12-21:
In the Enclosure version 0.1 (SLA) print the tile angle is a bit shallow. I would like the the T400 to tilt bacl a bit more.

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

It would be good to match the tilt angle and bail angle of this other device.
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

starno, 2015-01-24:
Tilt angle is open another 10deg, currently at 70deg.
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

Closed 2015-01-24.

Thread 47 (2014-12-21):

Tilting bail finger slot

charlespax, 2014-12-21:
In the Enclosure version 0.1 (SLA) print the tilting bail finger slot is a bit small. It is difficult to get my index finger and thumb in the slot.

Index finger
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

Thumb
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

The slot in the bail can be made larger
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

or we can remove some material from the back of the enclosure
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

starno, 2015-01-16:
The new bail files have bigger opening that fits fingers much better

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

charlespax, 2015-01-16:
Nice!

Closed 2015-01-16.

Thread 48 (2014-12-21):

Tilting bail snap

charlespax, 2014-12-21:
In the Enclosure version 0.1 (SLA) print I cannot snap closed the tilting bail. The bail just flexes. I have to press on both sides for it to snap. This is probably just due to the printing material. For the mold we should probably make the snap numbs a little smaller. Then we can always remove mold material and make them longer to get the right snap.
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

starno, 2015-01-22:
The new bail approach bypasses this problem all together.  We shouldnt have to worry about this anymore.

Closed 2015-01-22.

Thread 50 (2014-12-21):

Window tabs

charlespax, 2014-12-21:
To help secure the window we can add tabs that slot into the areas indicated below. This could be a good spot to to sonic or heat welding to the enclosure. However, adding tabs to the otherwise rectangular window would make manufacturing that part more complex and thus costly.

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

starno, 2015-01-22:
This was addressed in commit 6e667a0220e7789e9d8e74c5966f5af1079e687e.  There are 4 locations on the sides for the melt rivets, and the top and bottom of the window can either rely on the compression of LCD against the front when it is assembled or use a strip adhesive to attach it to the front.
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

charlespax, 2015-01-22:
That looks really good. Let's close this issue.

Closed 2015-01-22.

Thread 51 (2014-12-21):

Battery connector

charlespax, 2014-12-21:
In the Enclosure version 0.1 (SLA) print the battery connector area looks pretty good. The photos below include the taller 7-7 connector rather than the shorter 6-8 connector we've been using.

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

charlespax, 2015-02-19:
Nothing to see here. Closing issue.

Closed 2015-02-19.

Thread 53 (2014-12-21):

MicroSD card slot model

charlespax, 2014-12-21:
We have moved to a new MicroSd card slot. The model in the enclosure is the old one. The model should also reflect how far the card slot should hang over the edge. See https://github.com/PaxInstruments/t400-electronics/issues/79

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

starno, 2015-01-16:
Connector is now at 0.7mm from PCB edge to add more clearance from inside wall while also not protruding beyond the enclosure when sd is in the locked position.

charlespax, 2015-01-16:
Please add a screen shot.

starno, 2015-01-16:
From PaxInstruments/t400-electronics#79
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

charlespax, 2015-01-16:
Cool. Thanks :-)

Closed 2015-01-16.

Thread 54 (2014-12-23):

SD card during assembly

charlespax, 2014-12-23:
A MicroSD card will be inserted into each T400 during the PCBA process for testing. This will be the SD card that ships with the device. Therefore the enclosure should be capable of being assembled while the MicroSD card is installed in the device.

In this screen shot this looks like it will not be a problem. I need to pick up an SD card to confirm this.
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

starno, 2015-01-24:
This does not appear to interfere at all with assembly.  SD lines up nicely in prototype with no interference

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

Closed 2015-01-24.

Thread 55 (2014-12-23):

Silicone keypad height

charlespax, 2014-12-23:
In the Enclosure version 0.1 (SLA) print the keypad buttons are only slightly above the enclosure surface. Looking at it, I'm not sure if they are tall enough. This is something we should test once we have an Electronics version 0.9 PCB. Let's make this something address in Enclosure version 0.2 (SLA) if necessary.
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

starno, 2015-01-24:
The buttons currently sit 0.5mm above the front surface of the enclosure.  Now the silicone sits directly on the mechanical buttons, so it doesnt have room to fall back into the case anymore.  Do you think this is tall enough?

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

charlespax, 2015-01-25:
I think we'll have to do something more like 1.5 mm. In Enclosure version 0.2 (SLA) let's get several button lengths. We should try 0.5 mm, 1.0 mm, and 1.5 mm above the enclosure surface.

starno, 2015-01-26:
Ok, I have an STL of each size to get made.  The current model is defaulted to 1.5mm

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

Closed 2015-01-26.

Thread 56 (2014-12-25):

Battery compartment interior thickness

charlespax, 2014-12-25:
The enclosure shell is 2 mm thick all round. The interior of the battery compartment is also 2 mm thick. Can the wall thickness within the battery compartment be reduced without noticeably affecting the strength of the case?

If we can reduce this thickness, we will gain some space above the PCB without increasing the size of the enclosure.

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

starno, 2015-01-30:
The surface under the battery is thinner than the rest of the part.  Might cause blemishes, but it's pretty well hidden

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

Closed 2015-01-30.

Thread 57 (2014-12-26):

Injection molded windown

charlespax, 2014-12-26:
Right now we're using cut plastic sheet for the window. It may even be die cut with rivet holes (https://github.com/PaxInstruments/t400-enclosure/issues/50). It would be good to have an enclosure design that would allow an injection molded window in the future.

starno, 2015-01-22:
The most current solution can be lasercut or injection molded as is.
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

Closed 2015-01-22.

Thread 58 (2014-12-26):

Window chamfer

charlespax, 2014-12-26:
We have mild chamfer on the window. I had this in the original prototoype. Looking at the Enclosure version 0.1 (SLA) print, it doesn't seem to have an aesthetic point to it. Maybe we should have just a normal small 45 degree chamfer. This may go better with an injection molded window (https://github.com/PaxInstruments/t400-enclosure/issues/57) and give us a little more height to the branding area (https://github.com/PaxInstruments/t400-enclosure/issues/15).

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

starno, 2015-01-22:
So the buttons are pretty much fixed in place because of the wall between them and the PCB.  The overlap of the window chamfer on the LCD is also fixed because it covers up blank real estate on the screen.  So changing that chamfer to be 45deg will make the buttons look off-center.  are you sure that is worth it?

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

charlespax, 2015-01-22:
Getting some real estate for a molded-in logo _would_ be pretty sweet. The angle right now is so subtle that on the 3D print I really can't tell it's there.

We already have an SLA print of the current style. Maybe we should try changing the window chamfer and adding a molded-in logo for the next SLA print. Then we can compare the two physical prints. What do you think?

starno, 2015-01-22:
This was addressed in 3fe82aabea16d16189edf99ddfce018d29256202.  The chamfer is a sharper angle and adds more real estate.
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

Ill need the vector art to add in the logo mentioned in issue #59

Closed 2015-01-22.

Thread 59 (2014-12-26):

Pax Instruments logo on enclosure front

charlespax, 2014-12-26:
If we reduce the window chamfer (https://github.com/PaxInstruments/t400-enclosure/issues/58), we can get a logo on the front. It would be cool to have it molded into the case and maybe heat stamped.
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

starno, 2015-01-22:
Can you send me vector logo for this?

charlespax, 2015-01-23:
I've uploaded graphics to t400-enclosure/graphics.

charlespax, 2015-01-23:
Moving this to Enclosure version 0.2 (SLA).

starno, 2015-01-23:
Logo'd

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

charlespax, 2015-01-25:
Looks good :-)

Closed 2015-01-25.

Thread 60 (2015-01-02):

High-Cycle, Longer-Life Bail Design!!!

starno, 2015-01-02:
Here's an idea for an alternative approach at the bail/battery cover pair.  I think this is more promising for repeated cycles, and maintains the lock-open and lock-closed requirements.  It also can be made with a single-pull mold.

It works by having a flexible "wing" on the bail with a boss on the end:
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
There are corresponding holes on the battery cover to control it's position.

In the closed position:
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

As it opens, the wing flexes against the wall and creates resistance:
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

In the open position a notch on the battery cover wall allows the wing to return to its natural position, and prevents the bail from closing without user pushing on it:
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

If the bail is opened beyond its natural open position, it stops against the wall like the current bail:
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

Thoughts?

charlespax, 2015-01-04:
Looks good. With the right hold placement the bail should feel really solid.

How do you feel about getting some parts machined to try this out? We would need the battery cover, bail, and part of the enclosure back. We just need enough to test this with actual ABS. Better to test the mechanism early than to spend time fully implementing it only to find we don't like it.

starno, 2015-01-22:
I feel good about it.  CNCd out of ABS should be really telling for how well it will work.  This has been merged into the original files and replaced the old bail in all the CAD master files.

charlespax, 2015-01-22:
Do we need any chamfer on the highlighted edges?
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

starno, 2015-01-24:
The bail and battery cover assembly had a lot of refinements in 49284562307c798eb90a043f63ebbd4d5f7dcef9

Those particular edges have a drafted surface that acts like a chamfer.
![Uploading Capture.PNG . . .]()

Closed 2015-01-24.

Thread 61 (2015-01-03):

M2 or M3 screws?

charlespax, 2015-01-03:
In my original prototype I used M2 screws, which has carried over to the production design. I think it might be good to make explicit decision about this. @starno do you think the M2 screws be strong enough or would we need M3 screws?

starno, 2015-01-03:
I like the M2s, they dont take up a lot of space, and the inserts are tiny.  Do any of the prototypes feel insecure?

charlespax, 2015-01-03:
The threaded inserts didn't melt into the Enclosure version 0.1 (SLA) print because of the geometry (https://github.com/PaxInstruments/t400-enclosure/issues/39) and I think the material. The PLA prototypes I made months ago always felt fine.

starno, 2015-01-03:
I see.  For the insert bosses that do not fit, try the threaded inserts I bought, they have a smaller diameter and seem to be more abundant.  The mismatch with the battery cover has to do with opposite draft direction.  In fact, the majority of issues remaining are a result of drafting changing clearances, and I need to consult some friends on the best approach for this situation.  I think what needs to be done is breaking out some math and change the dimensions based on length of boss and angle of draft.

starno, 2015-01-22:
Fasteners added
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

Closed 2015-01-22.

Thread 62 (2015-01-03):

MicroUSB port squishes keypad

charlespax, 2015-01-03:
I put the Electronics version 0.9 PCBA in the Enclosure version 0.1 (SLA) print. In the image below you can see how the MicroUSB connector pressed directly against the keypad. Since the keypad in this print is hard SLA material, the buttons do not work. This may not be an issue in the silicone keypad.

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

starno, 2015-01-22:
As of now the buttons and connector are the same height, so it might affect the feel of 2/3 buttons on that side.  One option is to get taller buttons and a make a corresponding indent in the silicone to accommodate.  @charlespax  @samchoy88 Do we have a final button configuration/part number chosen already?

charlespax, 2015-01-22:
Here is a switch with a taller button. The height from PCB is 3.63 mm unpressed and 3.43 mm when pressed.

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

starno, 2015-01-22:
Ok, thanks.  That's going to interfere with the silicone buttons so I will add a recess
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

charlespax, 2015-01-22:
Will the distance between the keypad bottom and the microUSB connector increase? If not, I think we'll still have the squishing issue.

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

starno, 2015-01-22:
It did not increase but is able to.  I don't think the squishing issue will still be there because the silicone rests directly on the buttons and will be depressed before there is any contact with the usb connector.
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

charlespax, 2015-01-23:
I think the USB connector model may not be accurate. The gap that exists in the assembly did not appear to exist in the prototype. Can you physically verify there is a gap I. The prototype you have?

starno, 2015-01-23:
Good call, there was some interference there

there should be plenty of clearance there now
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

Closed 2015-01-23.

Thread 63 (2015-01-03):

Align 2x3 headers and enclosure cutouts

charlespax, 2015-01-03:
Based on the Electronics version 0.9 board and the Enclosure version 0.1 (SLA) print, we can probably locate the cutouts such that they align with a potential location for the headers on the PCB.

You can see i this image where a connected header cable could sit.
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

And here is the header seated on the board in that same spot inside the enclosure.
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

And here is the header on the board without the enclosure back.
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

For background information see https://github.com/PaxInstruments/t400-enclosure/issues/29
See electronics issue https://github.com/PaxInstruments/t400-electronics/issues/97

charlespax, 2015-01-23:
We're moving things in the electronics to work with the enclosure. Closing issue.

Closed 2015-01-23.

Thread 64 (2015-01-17):

Fastening PCB

starno, 2015-01-17:
Based on a discussion with @charlespax we decided to put the pcb onto bosses with a shoulder, the boss  passes through the PCB and the corresponding boss on from the back will meet up with it and keep everything constrained.

unfortunately a problem arises:
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
The front panel bosses are larger than the back because they need to contain the threaded inserts.  This makes the hole in the PCB larger and the back panel boss diameter is not large enough to prevent any unwanted movement of the PCB.  We either have to reconsider the assembly operation (since having shoulder bosses on the back panel solves the issue) or use the pinching method like before.

Thoughts?

charlespax, 2015-01-17:
I think shoulder bosses on the back is better than no shoulder. I don't think it would affect the assembly process since the LCD is already putting the PCB in the right place.

starno, 2015-01-17:
I agree.  I also did a test run of the assembly with the prototype models and if the fit is tight on the PCB putting the back on with the PCB on it doesn't make a huge difference.  Either way I'll switch up the configuration

charlespax, 2015-01-17:
Cool.

starno, 2015-01-22:
This was fixed in commit bc3faf97fd03e1f0dbca54480562c21bee565d81
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

charlespax, 2015-01-22:
The PCB mounting holes need to be changed, issue opened (https://github.com/PaxInstruments/t400-electronics/issues/139).

@starno please comment on the issue (https://github.com/PaxInstruments/t400-electronics/issues/139) with the new hole dimensions.

Closed 2015-01-22.

Thread 65 (2015-01-22):

Tilting bail lateral movement

charlespax, 2015-01-22:
It looks like the bail will be able to move left and right quite a bit. It even looks like the small nubs that hold the bail open or closed will disengage completely if the bail is moved to one side.

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

Should the two surfaces marked in yellow mate?
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

charlespax, 2015-01-23:
@starno what do you think?

starno, 2015-01-23:
No, I don't think they should mate.  The bail and battery cover still need finishing touches.  will report back

starno, 2015-01-24:
Ok, have a look at the files from 49284562307c798eb90a043f63ebbd4d5f7dcef9

Lateral movement is protected by the non-nub sides of the hinge in the center of the bail.  The length of both the axle boss and the locking wing boss both increased for strength and preventing accidental removal.
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

charlespax, 2015-01-25:
Cool. Looks like 0.26 mm. Let's close this out and readdress if the Enclosure version 0.2 (SLA) prototype has any problems.
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

Closed 2015-01-25.

Thread 66 (2015-01-22):

Tilting bail flexing

charlespax, 2015-01-22:
When the tilting bail is snapped into the battery cover the tilting bail must flex. Are the cutouts long enough to allow this?

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

starno, 2015-01-22:
so the thought here is that the cutout length needs to be on the shorter side of acceptable for two reasons:  it's a one-time snap; it must be harder to flex than the "wing" to avoid the bail from displacing or falling out when trying to open or close the bail.  The cnc parts will be telling.  Do you want to start longer than it is?

charlespax, 2015-01-22:
For the cutout length we should just machine what you have here. We can always hacksaw it longer to find the perfect length. However, the cutout width may not be enough. The cutout width is 1 mm. The nub is engaging with the battery cover 1 mm. It would be bad if the flexing part bottoms out before the nub disengages from the battery cover.

charlespax, 2015-01-23:
@starno can you do some measurements or FEA to see if what you have will work?

starno, 2015-01-24:
According to FEA calcs, a 40N (~9+lbf) load on the hinge nub will displace it the necessary 1mm to insert into the battery cover.
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

At that point the largest stress point is indicated in below in red, and is only half the yield strength of ABS.  So it looks pretty close to what we would want.
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

Closed 2015-01-24.

Thread 67 (2015-01-26):

Top panel orientation key

charlespax, 2015-01-26:
Right now the top panel is capable of being inserted in any of four orientations. We can add a small key onto the top panel and a keyway into the enclosure to ensure it can be inserted in only one orientation. This would not compromise the ability to use a 1.6 mm PCB as a top panel.

The notch would go on the front side or back side based on assembly order.

It could look something like this.
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

starno, 2015-02-02:
good call.  added two small locators on edge of top

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

charlespax, 2015-02-10:
The top panel can be inserted the wrong way. I'd have to check the SLA print, but I believe the enclosure cannot be screwed shut if it is wrong. Not a huge problem, but a worker would have to correct the mistake. We can avoid them making a mistake entirely if we add a single keyway to the center on the other side.
![Uploading ac2b407a-aad7-11e4-8c5b-3eddd7e07121.png . . .]()
Reopening issue and moving to Enclosure version 0.4 (SLA).

starno, 2015-03-20:
fixed.

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

Closed 2015-03-20.

Thread 69 (2015-01-30):

Silicone keypad keyway

charlespax, 2015-01-30:
Add some sort of keyway, so the keypads can only be inserted in the correct orientation.

starno, 2015-02-01:
This was fixed within commit 3a2cca8edb71a55d8e25bd33f46a8f3274f2db76  An explanation with picture can be seen in issue #80

Closed 2015-02-01.

Thread 70 (2015-01-30):

Tilting bail underside support

charlespax, 2015-01-30:
We need to make the battery cover such that the bail can snap without being in the enclosure back.

starno, 2015-02-02:
underside support is looking nice.  there is now a little interference when the bail is locked open.  things  should feel more robust

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

Closed 2015-02-02.

Thread 71 (2015-01-30):

Gap around enclosure

charlespax, 2015-01-30:
There is very little gap around the enclosure. This is the gap around the outside separating the front and back.

starno, 2015-02-01:
@charlespax This really hasn't changed from previous prototypes.  The gap there is 0.25mm, what would you like it to be?

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

charlespax, 2015-02-01:
To make a decision on this I will look at a few devices to get a sense of what looks good. I'll post my response here.

charlespax, 2015-02-10:
Woops! I didn't get to this in time. Moving to Enclosure version 0.4 (SLA).

charlespax, 2015-02-19:
Let's do 0.25 mm in the next SLA print and see how it looks.

starno, 2015-03-09:
@charlespax that means it will go unchanged.  should I close this issue?

Closed 2015-03-09.

Thread 72 (2015-01-30):

Top panel gap

charlespax, 2015-01-30:
Should we have a gap just like the outer edge (https://github.com/PaxInstruments/t400-enclosure/issues/71)?

starno, 2015-02-01:
I think both gaps should match

charlespax, 2015-02-01:
I agree. In the next version whatever we pick for the gap around the enclosure (https://github.com/PaxInstruments/t400-enclosure/issues/71#issuecomment-72352186) we should have for the panel.

charlespax, 2015-02-10:
Woops! I didn't get to this in time. Moving to Enclosure version 0.4 (SLA).

charlespax, 2015-02-19:
Looking at a few devices I thin 0.25 mm will be good. Let's to that and see what we get in the next SLA print.

charlespax, 2015-03-19:
Looks fine to me. Can we close this?

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

starno, 2015-03-20:
yep.  its at 0.25mm as desired

Closed 2015-03-20.

Thread 74 (2015-01-30):

Battery cover clearance

charlespax, 2015-01-30:
The battery cover is tight. We should increase the clearance at the top or have the top drafted more. Probably a combination of both.

starno, 2015-02-02:
This was fixed in commit 1d5f205a0f910df804bc58a5ef8371cb79da2760

The draft increased to 4 degrees.  Here is the comparison of gained clearance when inserting battery cover into back

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

Closed 2015-02-02.

Thread 75 (2015-01-30):

Battery cover thickness

charlespax, 2015-01-30:
If make the battery cover thinner, can we make the enclosure thinner by the same amount?

starno, 2015-02-02:
Yes we can but this is a pretty big change that involves more than one part.  I am hesitant to mess with the nominal thickness of one of the most complex and important pieces of the enclosure.  I don't think the 0.5mm gain is worth the hassle.

charlespax, 2015-02-03:
Cool. I'm moving this to Enclosure version :-)

charlespax, 2015-08-08:
Will not do. Closing issue.

Closed 2015-08-08.

Thread 76 (2015-01-30):

PCB standoff

charlespax, 2015-01-30:
We have shoulders on the rear enclosure standoffs (https://github.com/PaxInstruments/t400-enclosure/issues/64). For assembly it would be better to have these on the front panel. However the rear standoff width would be too small to capture the PCB.

Can we put the shoulder on the front panel and make the read panel standoff wider?

starno, 2015-02-01:
This is also overridden by going in the direction of issue #80

Closed 2015-02-01.

Thread 77 (2015-01-30):

LCD constraint

charlespax, 2015-01-30:
In Enclosure version 0.2 (SLA) the LCD is not constrained fully. There is a little less than a milimeter left to right and about 1.5 mm top to bottom. The LCD/PCB placement is perfect when the LCD is mated with the bottom constrain ribs.

If we get the LCD constrained well, the PCB will be in the right spot and which side the standoff shoulders are on won't matter (https://github.com/PaxInstruments/t400-enclosure/issues/76).

I think we should have something at the top constraining the LCD. We can't move the wall down as that would affect the top panel thickness. We can not make the wall thicker (I think) due to injection molding design constraints causing sink marks. We could probably add two or more ribs as we have at the bottom of the LCD.

If we add ribs, we would have to make the appropriate cutouts in the window panel.

starno, 2015-02-01:
I think this gets overridden based on our discussion with issue #80 being a cleaner approach.  @charlespax can you confirm?  If so, I will close

charlespax, 2015-02-01:
I agree. Closing issue.

Closed 2015-02-01.

Thread 78 (2015-01-30):

Buttons dont click

charlespax, 2015-01-30:
Not sure what's going on, but the buttons aren't clicking in Enclosure version 0.2 (SLA).

starno, 2015-02-01:
The button height dimensions given in #62 were 0.1mm off from what I measured on the prototype.  Since the keypad indents were modeled line to line sitting on top of the buttons, a tightly fastened enclosure could depress the buttons making them un-clickable.

I added the extra height to the modeled buttons, and added a 0.25mm clearance to avoid pinching in the future.

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

Closed 2015-02-01.

Thread 79 (2015-01-30):

SD card slot intererence

charlespax, 2015-01-30:
In Enclosure version 0.2 (SLA) the SD card slot does not match up with the enclosure. The card slot also interferes with the enclosure.

starno, 2015-02-01:
There is definitely some discrepancy here between the CAD and the prototype board.  The connector on the prototype measures a 1.3mm overhang from the pcb edge, when it should be 0.7mm.  (discussed in issue #53)
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
@samchoy88 @charlespax can you verify the overhang of the SD connector on the PCB is 0.7mm and the distance from the edge of the pcb to the centerline of the SD connector is 23.51mm?
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
If it is easier for me to shift the opening on the enclosure, I can do that too.  Let me know

charlespax, 2015-02-01:
In eagle I get 1.45 mm overhang. Opened issue  https://github.com/PaxInstruments/t400-electronics/issues/144

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

starno, 2015-02-01:
Please check the the distance from the side of the PCB as well since the alignment with the opening looks to be around 1mm off

charlespax, 2015-02-01:
Here you go.

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

starno, 2015-02-01:
Ok, that looks correct.  I must have the SD placement within the connector modeled wrong

starno, 2015-02-01:
Yup, that was it, and explains the shifted hole in the enclosure.  I had the SD card 0.2mm from the left edge of the connector when looking at its opening.  In the physical connector, this measures to be 1mm.  This was the missing information I mentioned https://github.com/PaxInstruments/t400-electronics/issues/79#issuecomment-68165430   The opening on the enclosure is based on the location of SD card and not the connector location, so it explains the shift.  If https://github.com/PaxInstruments/t400-electronics/issues/145 exposes some other dimensions that are off between the library component and the one we are working with, then we can reopen this issue.

Closed 2015-02-01.

Thread 80 (2015-01-30):

PCB locating feature

charlespax, 2015-01-30:
We can have two little nubs to help locate the PCB during assembly.

starno, 2015-02-01:
Locating features added.  They ride up the sidewalls of the front of the enclosure and pass through the PCB on either side.  This constrains the PCB during assembly in the Y direction, and there is a third rib extension that prevents the pcbs from going too far left.  The right side is prevented because the USB connector is in the way.
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
There is less than 0.1mm between the PCB and locating ribs after the draft.

An important thing to note is that the silicone buttons are the same part on both sides.  There is a chunk cut out of them that allows the locating ribs to pass through and this doubles as a way to prevent the silicone pieces from going in upside down.  However, during the icon printing process, the left and right sides need to be printed in opposite orientations.
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

charlespax, 2015-02-01:
We can't have a rib against the edge of the PCB because that edge will likely be a v-groove and have poor dimensional tolerance. The milled slots work well because we have good control over those dimensions.

charlespax, 2015-02-01:
Also, we should clear some space around the microUSB connector. We discussed a chamfer to give some clearance.

starno, 2015-02-01:
Good call.  I removed that locating rib against the pcb edge, reverted the larger USB opening to what it was and added a chamfer on the inside edge instead.

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

Closed 2015-02-01.

Thread 81 (2015-01-30):

Tight USB connector

charlespax, 2015-01-30:
In Enclosure version 0.2 the microUSB connector interferes with the wall a bit.

starno, 2015-02-01:
The connector was modeled as 7.5mm in width whereas the flared out portion at the entrance measures to almost 8mm.  It's now modeled as 8mm with same clearance around it.  This should fix it.

Closed 2015-02-01.

Thread 82 (2015-02-22):

Enclosure for 3D printing

cibomahto, 2015-02-22:
It would be awesome if there were STL files available for 3d printing a case based on the injection mold design. The solidworks parts are awesome but pretty huge to download over slow internet.

charlespax, 2015-02-22:
There are older set of  Solidworks and STL files for 3D printing in https://github.com/PaxInstruments/t400-enclosure/tree/master/3D%20Printed. After we go into production, we should update or redesign 3D printable files.

charlespax, 2015-02-22:
@starno has been having pretty good success with FDM 3D prints. The only significant problems is the bridging involved with the battery compartment.

cibomahto, 2015-02-22:
Yeah, no rush here- sometime after everything is finalized is probably soon enough :-).

charlespax, 2015-02-26:
We'l get to this at some point. Putting in ice box.

starno, 2015-02-26:
I've kept STLs out of the repo during development because the design is changing a lot and they quickly become useless, making the repo even larger.  As of now the only thing that has trouble with FDM are the small features on the bail.  Those features are going to be getting larger and if the production units are not easily printed, I can make a printable version.

charlespax, 2015-03-19:
At this point I don't think we need to commit to doing anything special. Let's see how the final design works for printing. Moving to ice box.

charlespax, 2015-08-08:
3D printing technology is good enough that people can order SLA prints of the actual enclosure. If we make another one that is good for 3D printing, I would consider it a separate product. Closing issue.

Closed 2015-08-08.

Thread 83 (2015-03-01):

Logo style

charlespax, 2015-03-01:
I think the logo on the enclosure is a bit weak with just the P-microscope. I'd like to try the logo with the circle and with the rounded square as seen in the images below. The outer shape would be an extrude cut into the enclosure. The P-microsope would be an extrude from the bottom of the extrude cut to the surface of the enclosure.

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

charlespax, 2015-03-01:
I've added Adobe Illustrator files to the repo.

starno, 2015-03-09:
First impressions is the rounded square will match the shape of what we got already.  I will post a comparrison

starno, 2015-03-09:
Hmm, here is a quick comparrison of the two:
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
I'm not so sure I like the border there because the logo needs to get much smaller to keep the same margin proportions.  My personal preference would be to emboss the logo there and maybe add some color to make it pop.  @charlespax what do you think?

starno, 2015-03-09:
Something kinda like this:
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

charlespax, 2015-03-09:
I agree with you. I guess we're down to two choices: colored logo on the enclosure or logo moved from enclosure to the front label. Do you have a string opinion either way?

charlespax, 2015-03-09:
If the logo were in the label, it would be smaller than a label embossed on the enclosure.

MLXXXp, 2015-03-09:
I don't know if you even care, but if the logo is on a stick-on label it makes it easier to OEM the product with a different brand. Embossing the enclosure makes it's more difficult to change. It's also easier if you decide to change your own company logo in the future.

You could also consider just adding a separate larger indent specifically for a logo sticker.

charlespax, 2015-03-18:
@MLXXXp I agree. We've discussed this before and I think that's a fairly compelling reason. Combined with my desire for flexibility, we should kill the embossed logo and add it to the front sticker.

@starno Let's kill the enclosure logo and move it to the sticker.

charlespax, 2015-03-19:
I just did a git pull and opened the file. The logo is still there for me. Am I missing something?
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

charlespax, 2015-03-19:
My fault. I was looking `master` rather than `starno`.
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

Looks done. Closing issue.

Closed 2015-03-19.

Thread 84 (2015-03-09):

Add rib to snap wings

starno, 2015-03-09:
The snaps are a bit weak at the base and showing some stress marks.  a small rib reinforcement should help here

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

charlespax, 2015-03-19:
With the other strength changes do you think you need to do this?

starno, 2015-03-20:
I think we can hold off on it.  Like you mentioned the snaps on the bail got a lot longer and stronger, so we can hold off unless it's needed again.

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

charlespax, 2015-03-20:
Okay. Moving this to ice box. If it's not a problem with the next prototype, we should close it.

charlespax, 2015-08-08:
Moving to 0.6 as something we should test when we get the prototypes back.

charlespax, 2015-08-10:
Added to the review checklist. Closing issue. We can reopen if necessary after test.

Closed 2015-08-10.

Thread 85 (2015-03-09):

Shallower angle on the snap wings

starno, 2015-03-09:
extending the snaps to span further along the edge of the bail can both strengthen the bail and wings

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

charlespax, 2015-03-18:
Since you're having trouble with batter interference with that design maybe this a viable option:
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

I don't think this interferes with anything.

charlespax, 2015-03-19:
Can we close this?

starno, 2015-03-20:
yeah, bail got a lot stronger

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

Closed 2015-03-20.

Thread 86 (2015-03-09):

Further tighten bail clearance inside cover

starno, 2015-03-09:
There is still too much wiggle room allowing it to slide back and forth when jostled

charlespax, 2015-03-19:
Looks good in the model. Can we close this?

starno, 2015-03-20:
@charlespax Im tempted to add in some bulbous features on the inside edge of the bail to give it a point contact with the battery cover and have minimal friction when opening.  The clearance between the two parts is tighter than the last prototype, but I'm starting to think something along these lines is the only way to eliminate it.  What are your thoughts?

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

charlespax, 2015-03-20:
That makes sense. Maybe put them on the most flexible parts of the tilting bail.

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

starno, 2015-03-20:
moving this to the production unit milestone.  Depending on how 0.4 comes out, this is something to iron out with tooling and make sure things are cut short so we can always add a bit of material until the fit is right.

charlespax, 2015-03-20:
Moved to milestone 0.5. The tooling milestone is only for things relevant to the tooling.

charlespax, 2015-08-10:
Okay, let's see if this problem comes up again in the next prototypes. If so, we can file a new issue. Closing issue.

Closed 2015-08-10.

Thread 87 (2015-03-09):

Keep snaps from escaping battery cover's grasp

starno, 2015-03-09:
Currently the bail "locks" open when the snaps pop out of the battery cover and sit in an open pocket.
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
The prototype is difficult to "unlock" from this position when closing the bail, however it is very easy to open back up again.  Therefore, the bail hinge needs to sit a little deeper inside the battery cover to prevent the snaps from ever becoming totally free.

charlespax, 2015-03-19:
Looks about right in the model. Can we close this?

starno, 2015-03-20:
Yeah, bail snaps managed to get longer, the locking positions moved toward the top, and the open locking position is recessed to prevent over extension.

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

Closed 2015-03-20.

Thread 88 (2015-03-19):

Top panel holes

charlespax, 2015-03-19:
We are developing a custom thermocouple connector (https://github.com/PaxInstruments/t400-electronics/issues/17). We may have to move the connector holes on the top panel to match. There is a 3D model in the electronics repository (https://github.com/PaxInstruments/t400-electronics/tree/master/solidworks/clip).

The enclosure 3D model should be updated with the connector model.

Current design:
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

starno, 2015-03-20:
I like this because it moves the holes in the top closer to true center.  I updated the PCBA to have these populated, but I left them in the same locations as the previous connectors.

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
resulting top panel:
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

@charlespax do you want smaller number indicators now?
@samchoy88 do you have coordinates of each thermocouple connector for me so I can match the PCBA in CAD to match the latest board files?

charlespax, 2015-03-20:
I don't have the coordinates for the connectors. Once the connector design is approved and we cut a PO, we will have an accurate model. The connector is still in the design phase.

charlespax, 2015-03-20:
The number can probably be a touch smaller, but I think it looks fine this way too. Let's get a prototype of this design and see how we feel about it.

charlespax, 2015-04-02:
The most recent prototype looked great. Closing issue.

Closed 2015-04-02.

Thread 89 (2015-03-19):

Peg slot chamfer

charlespax, 2015-03-19:
Should this be chamfered more?

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

starno, 2015-03-20:
Yeah, thats a good idea since the snap is stronger now.  The image above is 0.25mm flare at 0.75mm distance.  That seemed to work well with the encl-0.3 bail.  I just opened it to 0.4mm flare at 0.75mm distance.

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

Closed 2015-03-20.

Thread 92 (2015-03-23):

Silicone keypad graphics

charlespax, 2015-03-23:
@paxmanchris is taking care of the silicone keypad graphics.

The graphics can be found in the manual https://github.com/PaxInstruments/t400-electronics/blob/master/documentation/manual.md

Here are the dimensions we are working with.
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

A key here is to make a reusable interface if possible, so we can use this on other devices or people to use in their own projects.

Please add the graphics to a sub folder in https://github.com/PaxInstruments/t400-enclosure/tree/master/graphics

paxmanchris, 2015-03-23:
Here is a draft for the cycle icon
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

charlespax, 2015-03-23:
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

Cycle channels
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

Backlight
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

Power
![Uploading power_icon.png . . .]()

Logging start/stop
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

Log interval
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

Units: Unknown

paxmanchris, 2015-03-23:
Okay, I [uploaded the design](https://github.com/PaxInstruments/t400-enclosure/blob/master/graphics/buttons_worksheet.svg), staying as close to what was described in the [documentation](https://github.com/PaxInstruments/t400-electronics/blob/master/documentation/manual.md#buttons). Here is a picture what I have done so far:

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

@charlespax take a look and let me know if it needs to be tweaked.

charlespax, 2015-03-23:
Check out https://useiconic.com/open#icons, a bunch of free icons on github https://github.com/iconic/open-iconic.

paxmanchris, 2015-03-23:
Interesting but, I don't see any that fit what you want. Here is a mock up of the front panel with logos:

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

charlespax, 2015-03-23:
Icons from Google https://github.com/google/material-design-icons/releases/tag/1.0.0

Cycle channels: 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
Backlight:
Power: 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
Start/stop:
Interval: 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 or 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

Units:

charlespax, 2015-03-25:
There is also stuff form Font Awesome http://fortawesome.github.io/Font-Awesome/icons/

charlespax, 2015-03-25:
Here's a mockup on the SLA prototype.
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

paxmanchris, 2015-03-25:
Okay. Here is what I have so far:
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

charlespax, 2015-03-25:
Changes:

- Make the record circle the same size as the power button circle
- Make the temperature units button read "**°CFK**" or "**CFK**" in a single line. Do NOT do KFC :-)
- Make the delta t a little smaller. I don't know why, but it just looks really big

charlespax, 2015-03-25:
Here's a mockup with a smaller record button and a clock.
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

charlespax, 2015-03-25:
Empty thermometer
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

Filled thermometer.
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

charlespax, 2015-03-25:
Here's an updated screenshot
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

paxmanchris, 2015-03-25:
After discussing about it, here the interface with a half filled thermometer and graph without arrow.
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

charlespax, 2015-03-25:
Perfect!

paxmanchris, 2015-04-01:
I added a [pdf](https://github.com/PaxInstruments/t400-enclosure/blob/master/graphics/button_label_measurement_specifications.pdf) that lays out the button placement. All the buttons are separated into svg's and exorted as 600dpi png files,  [all in the repository](https://github.com/PaxInstruments/t400-enclosure/blob/master/graphics/button_label_measurement_specifications.pdf) . If the pdf looks good please close.

charlespax, 2015-04-02:
Use drawings with the white background. For each image, indicate the size of the image bounding box, not the distance to the edge. That will be much easier to measure.

paxmanchris, 2015-04-04:
I could not find the pdf of the white background for the buttons. Could you put the asset in the repo?

charlespax, 2015-04-04:
Here you go.

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

paxmanchris, 2015-04-04:
I updated the  [pdf](https://github.com/PaxInstruments/t400-enclosure/blob/master/graphics/button_label_measurement_specifications.pdf).

charlespax, 2015-04-05:
I think there is a problem. The clock and record icons are circles, but the document shows different height and widths for each.

paxmanchris, 2015-04-05:
I committed some the changes you requested. I know the backlight is still off, but if made square the center circle looks distorted. Please add updated buttons layout when you can

charlespax, 2015-04-05:
Post a screenshot.

charlespax, 2015-04-05:
I've uploaded the new keypad drawing in PDF PNG and DXF (vector) formats. Here is the PNG.
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

paxmanchris, 2015-04-05:
Here is the comparison:
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

Very minor. if you can tell me which is which then fine. Might make just to square it anyways.

charlespax, 2015-04-05:
I mean post a screenshot the same as I did with my feedback. I want to see what it looks like.

paxmanchris, 2015-04-06:
I think your right, and we should have the dimensions square.
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

charlespax, 2015-04-06:
Now the power button is messed up.

charlespax, 2015-05-05:
@paxmanchris what's the status of this?

paxmanchris, 2015-06-21:
This is done. we got the buttons :smile:

Closed 2015-06-21.

Thread 93 (2015-03-23):

Front panel graphics

charlespax, 2015-03-23:
@paxmanchris is taking care of the front panel graphics.

The graphics can be found in https://github.com/PaxInstruments/t400-enclosure/tree/master/graphics. Let me know if you need any other graphics to get this done.

Here are the dimensions we are working with.
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

paxmanchris, 2015-03-23:
@charlespax  What do you think of these?

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

paxmanchris, 2015-03-23:
See also [label_worksheet.svg](https://github.com/PaxInstruments/t400-enclosure/blob/master/graphics/label_worksheet.svg)

charlespax, 2015-03-23:
I think using the square or circle around the logo makes the microscope logo too small. We also end up with a ton of empty space. I think something like this would solve those two problems.
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

It also has the Pax Instruments name, which is nice. I think that will help with brand recognition. The microscope logo would be bigger than using the enclosed version.

MLXXXp, 2015-03-23:
Is it just going to say **T400**? With all that space, why not include the function of the device, such as **T400 Thermocouple Datalogger.**

When I pick up a new device for the first time, I find it nice to be able to find some indication of its purpose.

charlespax, 2015-03-23:
I think we should have "Pax Instruments on it" to help develop the brand. I do agree though, it would be nice to say what the device does.

charlespax, 2015-03-23:
Maybe if we just use "Pax" we can add "temperature datalogger"
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

charlespax, 2015-03-23:
Here is the type of label we'll have.
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

The label on this Rigol scope has the same 7.8 mm height as the T400 label. The calipers mark off the length we have to work with on the T400.
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

paxmanchris, 2015-03-23:
Okay, thanks for the input. Based on what you wrote, I added "temperature datalogger" to the label, and made a few designs with it:
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

charlespax, 2015-03-23:
Nice. That's starting to look pretty tight. I like how you have things divided. I think we'll have to print some of these and see how they look.

Here's another option:
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

paxmanchris, 2015-03-24:
Okay, revision 3. In the examples below:
1. blue, white, on black with white on gray for model number
2.  blue, black on white with  white on gray for model number
3.  blue, black on white

4, 5, 6 are the same only that "Pax" is clear.

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

paxmanchris, 2015-03-24:
@starno @MLXXXp  any thoughts on the revision?

charlespax, 2015-03-24:
What about something like this? Can you mock this up quickly?

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

paxmanchris, 2015-03-24:
Okay, here:

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

MLXXXp, 2015-03-24:
How about 3 (blue, black on white) but with **Temperature Datalogger" in blue?

paxmanchris, 2015-03-24:
I think it does not stand out well for blue **Temperature Datalogger**

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

paxmanchris, 2015-03-24:
Quick mockup of the bevel going the other way:

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

charlespax, 2015-03-24:
Of the layered design I like this the best. However, the layering seems a bit cluttered.
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

Having just the T400 blocked off looks pretty good.
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

I also really like the simple style of this one.
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

MLXXXp, 2015-03-24:
**paxmanchris** wrote:
> I think it does not stand out well for blue **Temperature Datalogger**

Then I think you'd have to say that **Pax** doesn't stand out well either.

paxmanchris, 2015-03-24:
Some variations one the one we like:
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

1. original from last post
2. larger temperature datalogger
3. cleaned up, the right edge of t400 and the inner edge of the I in the P are the same distance from the outer edge (about 2mm).
4. The P looked a little to close to top, so I centered it. But now the bottom T400 is no longer flush with the brand (it did not loot right with with T400 uncentered). Yet I still like this one.

Here is with the T400 flush with the logo if moved down:
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

MLXXXp, 2015-03-24:
Number 4 and the last one have too much white above and not enough below. It doesn't look vertically centred and gives the impression of wasted space, especially from a distance.

I prefer number 3. The top of the **P** being close to the top edge doesn't seem too bad to me. **Temperature Datalogger** could maybe be slightly larger, though not a big as number 2.

MLXXXp, 2015-03-24:
I don't know if the **PAX** logo is cast in stone but I'd consider making the **AX** larger. Right now, there could be a slight chance that some people might ignore the microscope and arm part of the **P** and see **IAX**. **INSTRUMENTS** could remain as it is, thus becoming slightly smaller overall.

charlespax, 2015-03-25:
"Temperature Datalogger" should be black. The color blue is reserved for the Pax Instruments logo and things that enhance our brand, like the enclosure color.
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

Other than the microscope being too close to the top, this one does look well balanced. I like that the bottom edges of the text are aligned.
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

This one does seem a bit too low. It looks strange without the alignment.
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

I think the last one looks best.
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

I did a rough edit to the image below. The microscope is a touch closer to the top than to the bottom, but not as close as before. "Temperature Datalogger" and "T400" are a touch larger, which I feel is too large.
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

@MLXXXp can you make some mockups of what you think would look good? The graphics assets can be found at https://github.com/PaxInstruments/t400-enclosure/tree/master/graphics

MLXXXp, 2015-03-25:
Now that I've seen **Temperature Datalogger** in a larger font, I'd have to say I prefer the original size.

As I've said, I don't see the **P** being close the the top as being a problem, so I like the vertical balance of the second one above. I took that one and moved the **T400** so it's closer to the same distance from the right edge as **PAX** is from the left. I also moved **Temperature Datalogger** slightly to make it look centered.

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

Have you considered switching the model and description? I'm not sure which I prefer.

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

charlespax, 2015-03-25:
Both of those look good. The T400 on the right visually appeals to me a bit more. However, I think the T400 in the middle reads better: "Pax Instruments T400 temperature datalogger" is how I've been talking about he device. Let's go with the second option.

@paxmanchris upload an SVG with 600 dpi PNG and JPG files. I also need a PDF indicating the dimensions of the label. Let's take the label in 0.3 mm, so we'll have 72 mm x 7.5 mm.

charlespax, 2015-03-25:
I've ordered labels. Closing issue. We can make a new issue if there is a problem.

Closed 2015-03-25.

Thread 100 (2015-03-25):

Silicone keypad keying

charlespax, 2015-03-25:
The silicone keypads can be inserted in the wrong holes. I'd like the two keypads to be separate designs, such that a worker cannot make a mistake.

starno, 2015-03-29:
left and right versions initiated.
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

Closed 2015-03-29.

Thread 95 (2015-03-25):

Top panel recess

charlespax, 2015-03-25:
Cross posted from https://github.com/PaxInstruments/t400-electronics/issues/17

There may be a problem with how deep the connector inserts into the T400.

Here is the current connector version.
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

The thermocouple would have to go a minimum of 5.7 mm into the connector to make contact. The shortest thermocouple connector I've seen is about 10 mm. Those numbers work well if the male part is fully inserted into the female part.
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

For the T400 a male thermocouple connector must pass through the enclosure and a gap before it inserts into the female connector. In this image the black line marks off the point of contact.
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

We could have an indentation in the top panel, so the male connectors would only have to pass through the thickness of the enclosure. That would get the job done, but isn't the best contact and may not be very secure.
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

We could remove the tab from the entrance of the connector and have two tabs on the sides. This would allow us to hang the connector over the edge and span the gap or part of the gap.
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

This would, however, cause some assembly problems when installing the top panel. I think we could overhang about 1.5 mm without causing problems. Perhaps a combination of wings on the sides and an indentation in the top panel is the solution.

Update: I accidentally removed the flange from the entrance. We would probably have a flange going up and a flange going down to aid thermocouple insertion.

starno, 2015-03-25:
Are you proposing to make a recess on the top panel to give the connector pins more guaranteed depth inside the mating connector?

charlespax, 2015-03-25:
Yes

charlespax, 2015-03-25:
It looks like a recess would be too close to the edge. We would have to make the whole top panel one flat piece. I hope we can address by changing the connector. We could also extend the PCB, but that wouldn't be as clean.

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

starno, 2015-05-04:
Here is the current arrangement with the new SMT connectors:

Top panel no longer has channels for the male end of the thermocouple connector, and sits 0.48mm from the inner surface of the top panel:
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

The shortest connector I have is the Chinese knockoff which has 10mm long male contacts.  Approximately 2.5mm of that will be going through the top panel and clearance before the connector, with the remainder inside the connector.  The bottom edge of the inlet also aligns with the bottom edge of the connector, so all the force after insertion will be displacing the spring portion of the connector:
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

I think this issue can be closed.

charlespax, 2015-05-04:
I don't see those top panel changes in git hub in either starno or master.

starno, 2015-05-04:
Hmm, it was part of this commit:
https://github.com/PaxInstruments/t400-enclosure/commit/2cebe68f543333da7238f13286a397d0a8f6d0ea

charlespax, 2015-05-04:
Oh I see. I have to `git checkout starno` and `git pull` to get the updates. If I'm on `master`, `git pull` does not bring in updates in `starno` and does not tell me that it was updated. I have the changes now. Closing issue.
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

Closed 2015-05-04.

Thread 96 (2015-03-25):

SD card insertion

charlespax, 2015-03-25:
The SD card can be lost int he device if it is inserted at an angle.
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

We should be able to solve this by adding ribs where I marked the black lines.
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

starno, 2015-03-29:
I extended existing ribs on the front and back panels so that the clearance is smaller than the SD card
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

Closed 2015-03-29.

Thread 97 (2015-03-25):

Button height

charlespax, 2015-03-25:
As we discussed, the button height could be reduced. However, the current height has been growing on me. I'm still not sure what we should do.

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

What do you think of reducing the height on only the power button? This could avoid the device accidentally turning on while stored. Thoughts?

starno, 2015-03-29:
At the moment I think they are a little too big and a little too easy to accidentally press while holding it.  Slightly recessed power button is interesting idea.  We can probably make it subtle enough that it has the preventative functionality without the user recognizing a difference in height

charlespax, 2015-04-02:
You have the other buttons of various height. Which do you like best?

charlespax, 2015-04-02:
You have the other buttons of various height. Which do you like best?

starno, 2015-04-05:
I think 1.0mm above the enclosure surface feels the best.

charlespax, 2015-04-07:
I like the feel of 1.0 mm also. Let's go with that.

starno, 2015-08-08:
1.0mm it is

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

Closed 2015-08-08.

Thread 98 (2015-03-25):

SD card slot

charlespax, 2015-03-25:
The bottom edge of the SD card slot should come up some more.

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

starno, 2015-03-29:
done

The height of the latest sd connector was not updated in the CAD
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

should be better now
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

Closed 2015-03-29.

Thread 99 (2015-03-25):

Locating rib height

charlespax, 2015-03-25:
I think we should increase the height of the two PCB locating ribs. In the picture below the T400 is flat against a table and the buttons are installed. Since the buttons normally protrude from the enclosure from surface the button will lift the PCB away from the enclosure resulting in a very small engagement between the locating ribs and the PCB slots. This effect would be reduced if we decrease the button height (https://github.com/PaxInstruments/t400-enclosure/issues/97). Making the ribs taller would improve a workers ability to accurately locate the PCB.

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

starno, 2015-03-29:
fully extended height of ribs to meet the front panel outer edge
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

Closed 2015-03-29.

Thread 102 (2015-04-05):

Battery cover closing

charlespax, 2015-04-05:
It seems that the battery cover does not close unless I press down a bit. Without the battery in place the battery cover closes completely with no pressure. I think the battery is probably thicker than the battery model.

charlespax, 2015-04-05:
It looks like the battery was getting puffy. No problem with the enclosure. Closing issue.

Closed 2015-04-05.

Thread 105 (2015-04-07):

LCD support

charlespax, 2015-04-07:
The LCD has a habit of popping up a bit from the housing. I think we'll need to put a bit of adhesive backed foam on the front window to help hold it down.
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

This is the LCD pressed into place.
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

charlespax, 2015-05-05:
Added to production milestone.

Thread 107 (2015-05-04):

Thermocouple slots

charlespax, 2015-05-04:
I measure the thermocouple slots at about 1.5 mm:
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

This is probably a little too big. With the new PCB thermocouple connector a male thermocouple can flatly hit the tab while being inserted.
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

I believe the PCB connector is designed to accept thermocouple up to 1.1 mm, is a little larger than any thermocouple connector I've seen. I think we can close the slot a bit to prevent the male TC connector from hitting the tab and also protecting the PCB connector from being damaged by overly large male TC contacts.

starno, 2015-08-08:
@charlespax is this issue still relevant with the latest connectors?

charlespax, 2015-08-08:
I don't think it would be a problem, but I would like to tighten up that dimension to 1.3 mm with the bottom edge of the hole aligning with the inside bottom edge of the connector.
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

starno, 2015-08-08:
done.

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

Closed 2015-08-08.

Thread 108 (2015-06-18):

Front label recess

charlespax, 2015-06-18:
The recess for the front panel sticker should be deeper. I measure 0.35 mm for the sticker thickness. Can we do a touch deeper than that?

starno, 2015-08-08:
How deep do you want to go, 0.5mm?  I'm already concerned this is going to be a problematic area because its already bending the design rules about keeping a nominal thickness and the bezel needs to be a regular shape or it will just be an eyesore.

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

charlespax, 2015-08-08:
How deep is it now? How do you feel about 0.35 mm or 0.4 mm, so the label is at least flush?

starno, 2015-08-08:
It was at 0.25mm, I made it 0.4mm because we can always make the depth shallower if problems arrise.

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

Closed 2015-08-08.

Thread 109 (2015-08-08):

LCD cover files

charlespax, 2015-08-08:
@starno please add a file suitable for laser cutting the LCD cover to the repo. I'll order samples for this next set of prototypes.

starno, 2015-08-08:
added lasercut directory and dxf of window

charlespax, 2015-08-08:
What's the thickness of that window?

starno, 2015-08-08:
0.5mm

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

charlespax, 2015-08-08:
Thanks. What is tolerance can we handle with that?

starno, 2015-08-08:
+0 / -0.1mm I'd say.  Its going to cause trouble if its too thick, and I have never had sheet of material too thick, I think theyre always are thinner than advertised

charlespax, 2015-08-08:
Cool. Thanks.

Closed 2015-08-08.

Thread 110 (2015-08-08):

Thermocouple connector changes

charlespax, 2015-08-08:
The factory had a few problems and I made changes to the thermocouple connector design to address their tolerances. Then entry bends are now 45 degrees and the connector gap is specified at 0.6 +/- 0.1 mm as seen in the image below. From testing their samples the connector should still be able to bend without permanently deforming. I will be at the factory during production to spot check connectors and try to keep the factory to a tighter tolerance.

The 3D model should reflect these changes.

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

starno, 2015-08-08:
Ok, updated the CAD.  I like this change as it completely eliminates the concern with issue#107

 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

Closed 2015-08-08.

Thread 111 (2015-08-10):

Review 0.5 prototypes

charlespax, 2015-08-10:
Here are some things to check when we get the 0.5 prototypes and address in 0.6 if necessary

- [x] Bail lateral movement #86 Make sure this is not too loose
- [x] Snap wing ribs #84 Test for unacceptable wear on this part. Possibly add a rib.

Closed 2015-08-27.

Thread 115 (2015-08-13):

SD card constraint

charlespax, 2015-08-13:
As described in #96 the SD card can be lost int he enclosure. This is still true in the latest enclosure (0.5) design. The SD card can be inserted above the card slot.
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

starno, 2015-08-18:
Added a second rib above the slot so it shouldn't be possible to miss the connector anymore.  The bottom is already limited to where the existing rib is, but it's protecting that area just fine with the prototype

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

Closed 2015-08-18.

Thread 116 (2015-08-13):

Squishy bail

charlespax, 2015-08-13:
The tilting bail feel mostly perfect. However, when the bail is fully extended it does not feel solid. This was only tested int he SLA 0.5 print. I'll test this in the 0.5 CNC parts.

charlespax, 2015-08-27:
It felt okay on the CNC parts. The slot the nub goes into was not cut quite right though. Closing issue.

Closed 2015-08-27.

Thread 117 (2015-08-13):

Laser cut window misalignment

charlespax, 2015-08-13:
The bottom edge of the laser cut window does not sit in the depression on the 0.5 SLA print. It works fine on the 0.4 print.

charlespax, 2015-08-14:
Here you can see the overlap.
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

starno, 2015-08-18:
turned out to be the vendor's mistake, as the modified window matches the CAD

charlespax, 2015-08-26:
This was actually my mistake. I sent them an earlier file. I fixed this and all is well.

Closed 2015-08-18.

Thread 118 (2015-08-13):

Front label depression size

charlespax, 2015-08-13:
On the 0.5 SLA prints the from label depression may not be large enough. It seems fine on 0.4. Could be SLA dimensions are off or the sticker I have is larger than the previous one.

charlespax, 2015-08-14:
Looking at the other prototypes it's also a little tight. Let's make it a little bigger. Maybe 0.4 or 0.5 mm larger on each side.
![Uploading IMG_20150814_184827.jpg…]()

starno, 2015-08-18:
This breaks some of our early design and alignment rules, but the changes are in.  0.5mm border around sticker logo:
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

Closed 2015-08-18.

Thread 119 (2015-08-14):

SD slot size

charlespax, 2015-08-14:
Let's tighten up the SD card slot size.
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

starno, 2015-08-18:
tightened up the slot to be 0.3mm on top and bottom, 0.5mm on sides
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

Closed 2015-08-18.

Thread 120 (2015-08-14):

LCD bezel

charlespax, 2015-08-14:
We should tighten up the bezel. The LCD is recessed a little, so a user is able to see the edges of the LCD.
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

starno, 2015-08-15:
bring in 1mm on each side

starno, 2015-08-18:
brought in the bezel 1mm.  LCD border outline for reference:

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

Closed 2015-08-18.

Thread 121 (2015-08-14):

Tilting bail snap open

charlespax, 2015-08-14:
We should rethink the tilting bail a bit. The tilting bail has a really nice snap when it's closed. On the CNC parts the snapping open is a bit squishy. The wings don't snap into the track very well. However, the features on the bail and battery cover that are supposed to prevent over extension actually work quite nicely as a snap open feature.

Here is where we intended the bail to stop; where the nubs enter the track. You can see the highlighted features. The feature on the battery cover resists the bail from going further.
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

With a small amount of force I can snap the bail feature over the battery cover feature. This gives a stable hold.
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

This causes the battery cover to flex a bit.
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

We should be able to reduce this by adding plastic in the highlighted area.
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

Then we can exploit this as a feature by adding relief slots to the battery cover, so it can flex.
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

starno, 2015-08-15:
mockup wingless version and the current design with better snaps, reliefs, and reinforcements

charlespax, 2015-08-27:
We'll get a CNC set of the alternate parts.

Closed 2015-08-27.

Thread 122 (2015-08-14):

Threaded insert supports

charlespax, 2015-08-14:
The threaded insert ont he battery cover is not held on by much. We should add some support ribs.
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

starno, 2015-08-18:
added 3 ribs where there was room.  its possible to get a 4th rib if we move the thermocouple panel keyway to either side a few cm.  @charlespax what are your thoughts?

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

charlespax, 2015-08-18:
Moving the keyway is okay as long at is doesn't line up with a keyway on the front.

starno, 2015-08-18:
4th rib added and keyway shifted over 12mm.
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

The slot never actually touches the battery cover every, so it can be anywhere on that side
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

Closed 2015-08-18.

Thread 123 (2015-08-14):

MicroUSB hole

charlespax, 2015-08-14:
I'd like to tighten up the MicroUSB hold. I think that would improve the look.
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

starno, 2015-08-18:
I dont think we can get any tighter than we are at already because there are the tabs that flare out in all four directions.  @charlespax what exactly do you want to do here?

charlespax, 2015-08-18:
What can you do to contour the hole around the connector shape? On the front piece it should be pretty easy to round off the corners. On the back piece we would have some sharp corners on the piece that sticks up.

We could change the shape of the hole a little, so there are no sharp corners. In the image below the yellow line shows the contour of the front and green shows the back. What do you think about this solution?

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

starno, 2015-08-18:
Looks good.  implementing...

starno, 2015-08-19:
USB slot looks a lot less blocky now.  Same amount of clearance around connector except the overall shape of the hole resembles the connector better.
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

 I also changed the SD slot to be similar.  @charlespax what are your thoughts on the SD slot, better now or the way it was?

![Uploading Capture2.PNG…]()

charlespax, 2015-08-19:
Looks really good in the first screenshot. The second one didn't upload, but I can see from the first one the SD slot looks good too.

starno, 2015-08-19:
oops

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

charlespax, 2015-08-19:
Yeah, looks good :-)

Closed 2015-08-19.

Thread 125 (2015-08-26):

Unable to locate threaded inserts

charlespax, 2015-08-26:
on commit 73edde1ac90ea6bb947693806ebfc6a88ce5d0d4

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

charlespax, 2015-08-26:
Reopened and now it's fixed. No problem here.

Closed 2015-08-26.

Thread 126 (2015-08-26):

MicroSD slot edges

charlespax, 2015-08-26:
In commit 73edde1ac90ea6bb947693806ebfc6a88ce5d0d4 the SD card slot look really good. The corner on the back edge seems like it has a large radius. How do you feel about squaring it off a bit to have the same radius as the inside corner of the front?

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

starno, 2015-08-27:
I agree with you, it looks a bit off.  I could have sworn it was concentric already...

starno, 2015-08-27:
fixed.
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

Closed 2015-08-27.

Thread 127 (2015-08-26):

Tiny sliver edge

charlespax, 2015-08-26:
From commit 73edde1ac90ea6bb947693806ebfc6a88ce5d0d4, would this sliver cause any problems for the tooling?

This is the battery cover.
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

Maybe this tiny feature on the tip can't be machined the way it is modeled.
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

charlespax, 2015-08-26:
I think issues like this would be brought up when the factory evaluates the design. This should not hold up the 0.6 SLA print. Moving to production milestone.

charlespax, 2015-08-26:
There are other similarly thin features on the battery cover.

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

starno, 2015-08-27:
at the moment there are a few areas with small features like this.  They are needed to satisfy the draft angles and pull directions.  We can work with the tooling house to optimize where the parting line is and how to minimize the appearance

charlespax, 2015-10-15:
No issue form factory.

Closed 2015-10-15.

Thread 128 (2015-08-26):

Bail-battery cover contact

charlespax, 2015-08-26:
In commit 73edde1ac90ea6bb947693806ebfc6a88ce5d0d4 the tilting bail looks to have pretty good contact with the battery cover. Is this what we had in the previous version or did you beef this up?

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

charlespax, 2015-08-27:
This is different.

starno, 2015-08-27:
yeah, this is beefed up so that it cant overshoot the stop like it did on the last prototype, both locking positions are controlled by the wings

Closed 2015-08-27.

Thread 129 (2015-08-27):

Tilting bail wear area

charlespax, 2015-08-27:
The alternate tilting bail looks pretty good. The feature that keep the bail open and the feature that keep the bail closed will wear on the same area of the tilting bail.
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

If the ribs can be moved off to the side, the two features will wear the tilting bail in different spots. I don't know how significant this will be, but it would be worth doing if moving the features does not cause any problems.
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

starno, 2015-08-27:
great idea

starno, 2015-08-27:
locking open and locking closed now touch the bail in different areas

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

Closed 2015-08-27.

Thread 131 (2015-09-03):

Tilting bail wall interference

charlespax, 2015-09-03:
In this image you can see how the wall on the tilting bail interferes with the battery cover.
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

Here is a modded CNC version on top of the pervious SLA print with now wall.
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

charlespax, 2015-09-03:
Fixed. Added some angles too.
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

Closed 2015-09-03.

Thread 132 (2015-09-03):

Wing slots

charlespax, 2015-09-03:
These two images shows how the two wing slots are different. The one to the left actually prevents the wing from fully flexing out. Make the left like the right.
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

charlespax, 2015-09-03:
This problem is from the tilting bail master file.
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

charlespax, 2015-09-03:
Fixed.
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

Closed 2015-09-03.

Thread 133 (2015-09-03):

Wing length

charlespax, 2015-09-03:
The ends of the wings bottom out on the battery cover, preventing the nubs from nicely entering the slots. The wings should be cut similarly to this image.
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

charlespax, 2015-09-03:
I cut away from what was there. Fully constrained. I chose dimensions based on what would not require any changes to the fillets later in the tree. Will close when changes are pushed.

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

charlespax, 2015-09-03:
Made some adjustments to give a little more clearance between the wing tip and battery cover.
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

Closed 2015-09-03.

Thread 134 (2015-09-03):

Tight button holes

charlespax, 2015-09-03:
On the most recent CNC parts the buttons are a little too snug in the button holes. In previous SLA prints the holes have been fine. I'll have to test in the recent SLA prints when I get them. Not sure if it's an issue with the model or with the technology.

charlespax, 2015-09-22:
The holes are fine int he SLA print. I'm moving this to the production milestone as some thing to look out for.

Thread 135 (2015-09-03):

Window file

charlespax, 2015-09-03:
The laser cut LCD window fit in the previous SLA prints, but does not fit int he current CNC enclosure. I need to get the new SLA print and compare.

charlespax, 2015-09-22:
I made a new window. The updated file is in the repo.

Closed 2015-09-22.

Thread 136 (2015-09-03):

Front label

charlespax, 2015-09-03:
The front label is a different size. I have to make a new file and new labels. I should also consider a new design.

charlespax, 2015-09-22:
Here are the dimensions of the sticker area. We should leave 0.3 mm around all sides.

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

charlespax, 2015-10-10:
Here is a sample of what I'm working on. I don't really like it though. I think the PI logo is just the wrong aspect ratio. Difficult to work with.

The area is 9.8 x 74.3 mm with r=1.5 mm. Leaving a 0.25 mm gap on all sides we have 9.3x73.8 mm with r=1.25 mm.
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

Thread 138 (2015-09-03):

Thermocouple holes

charlespax, 2015-09-03:
I think the holes can be tightened up a bit.

charlespax, 2015-09-22:
No need. They seem fine in the latest prototype.

Closed 2015-09-22.

Thread 139 (2015-09-03):

Threaded inserts

charlespax, 2015-09-03:
We are using threaded inserts. Talk to the chosen factory and determine how we should change the model to accommodate this.

charlespax, 2015-10-09:
The factory will injection mold the enclosure around the threaded inserts, it will not be a secondary operation. I have to select a threaded insert for them to use. I'm not sure what I need to do to change th model. We'll have to talk about this with the factory once I select an insert.

Thread 140 (2015-09-03):

Injection molded window

charlespax, 2015-09-03:
Make an injection molded window for quoting. This may not be very expensive.

charlespax, 2015-10-02:
The 0.8 mm PC laser cut window works well.

Closed 2015-10-02.

Thread 141 (2015-09-03):

LCD window heat stake

charlespax, 2015-09-03:
We may be able to put additional heat stakes at the top of the window. This would require changing the front a little and the window a little.

charlespax, 2015-09-22:
I put a row of heat stakes at the bottom. This will not interfere with the LCD. There isn't a nice way to put them at the top. However, the top of the window is well supported by the LCD bezel.

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

Closed 2015-09-22.

Thread 142 (2015-09-03):

Window thickness

charlespax, 2015-09-03:
The plastic housing of the LCD panel may not press directly against the window/front. If there is a gap, we can make the window thicker.

charlespax, 2015-09-22:
I think we can do 1 mm. I have to do a test with two panels in the enclosure.

charlespax, 2015-09-22:
Two 0.5 mm, which I measured at 1.00 mm, were too thick. I think we can hit 0.70 to 0.80 mm on the window thickness.

charlespax, 2015-10-02:
0.8 mm worked great on Milestone 7 SLA enclosure. Moving to production milestone.

Closed 2016-09-15.

Thread 151 (2015-09-27):

MicroUSB hole inside

charlespax, 2015-09-27:
If we use a new MicroUSB connector, ensure the holes works with it. See https://github.com/PaxInstruments/t400-electronics/issues/203

charlespax, 2015-10-02:
Just use the flanged one.

Closed 2015-10-02.

Thread 152 (2015-09-27):

MicroUSB connector interference

charlespax, 2015-09-27:
I think the MicroUSB connector interferes with the enclosure a little. Make sure this is solved in the most recent SLA parts.

charlespax, 2015-10-02:
Solved.

Closed 2015-10-02.

Thread 153 (2015-10-02):

Battery cover insertion

charlespax, 2015-10-02:
The corner of the batter cover hits the enclosure back a little when installing the battery cover. It would be good to add come chamfering to both parts to make it smoother.

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

charlespax, 2015-10-08:
Will not be a problem now that the battery connector is covered. See https://github.com/PaxInstruments/t400-enclosure/issues/162

Closed 2015-10-08.

Thread 154 (2015-10-02):

MicroUSB hole perfection

charlespax, 2015-10-02:
The hole should be moved up maybe 0.15 mm. Maybe some other work in the corners too.

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

charlespax, 2015-10-06:
We also need some more clearance for the connector. The flanges interfere with the case a bit.

charlespax, 2015-10-10:
Fixed the clearance issue in 9ba5ce395d3ddf612e57fe1495cb6986d18d1b03. The hole lines up prety well, so I'm not going to change that. Closing.

Closed 2015-10-10.

Thread 155 (2015-10-02):

MicroSD slot

charlespax, 2015-10-02:
The top of the slot needs to come down a bit. Maybe 0.5 mm.

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

charlespax, 2015-10-08:
Brought it down by 0.4 mm, leaving a 1.2 mm gap. MicroSD cards are about 0.98 mm at the thickest point.

Closed 2015-10-08.

Thread 157 (2015-10-02):

Battery cover gap

charlespax, 2015-10-02:
I think we can tighten up the side gap a bit.

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

charlespax, 2015-10-08:
It's actually fine. It looks like the SLA print came in a bit undersized.

Closed 2015-10-08.

Thread 158 (2015-10-02):

Thermocouple slot location

charlespax, 2015-10-02:
It looks like the slots put the thermocouples slightly above the female connectors. Fix if necessary.

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

charlespax, 2015-10-08:
Upon further inspection the connector location look quite good. Closing issue.

Closed 2015-10-08.

Thread 159 (2015-10-02):

M2 screws in back

charlespax, 2015-10-02:
In the Milestone 7 SLA and CNC parts the M2 screws do not fit through the Back. There may be a step inside the hole.

charlespax, 2015-10-08:
No step in CAD or in SLA. That was just from the CNC process.
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

Closed 2015-10-08.

Thread 164 (2015-10-09):

Factory design change requests

charlespax, 2015-10-09:
The injection molding factory is reviewing the design files. They are making changes to the files to show their requested changes and will send them back to me with screenshots showing before and after the changes and indicating where the changes is made in the parametric tree. Then we have to look at these changes and include what we can in the design.

We have to manually replicate their changes in our design rather than directly using their edited files. This will ensure only approved changes make it into our design. Make issues for the design change requests.

Closed 2015-10-10.

Thread 165 (2015-10-10):

Top panel fillet

charlespax, 2015-10-10:
Based on factory feedback, remove this fillet on the top panel.
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
This does not appear to cause any assembly problems. Let's do it.

charlespax, 2015-10-10:
Done.
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

Closed 2015-10-10.

Thread 167 (2015-10-10):

Back panel fillet

charlespax, 2015-10-10:
Based on factory feedback remove this fillet.
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

charlespax, 2015-10-10:
I think we should keep this as it will aid assembly. The mating edge had a fillet, so it may not be an issue.

Closed 2015-10-10.

Thread 172 (2015-10-11):

Back/Battery cover threaded insert hole

charlespax, 2015-10-11:
The threaded insert that holds the battery cover is set in a hold that goes clear through the enclosure. If someone uses an extra long screw, the screw can touch the PCB. Close the bottom to prevent this.

charlespax, 2015-10-15:
Done.

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

Closed 2015-10-15.

Thread 175 (2016-01-04):

Plastic resin light transmission

charlespax, 2016-01-04:
The production enclosures transmit more light than the older sky blue sample shots. This affects the appearance a bit as light reflects differently on this material. The LCD backlight shines through noticeably in low light conditions.

Thread 176 (2016-01-04):

Tilting bail rib error

charlespax, 2016-01-04:
There is a small piece of rib missing from a tilting bail rib. Cosmetic issue. Let's fix it if we make a lot of enclosures.
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

Thread 177 (2016-09-15):

LabWiz LCD protector

charlespax, 2016-09-15:
For LabWiz I want to have a nicer LCD protector. It should be machined from a scratch resistant PC sheet that is thicker than the T400 laser cut sheet. The area around the edges will be machined to match the thickness of the T400 sheet. This way it will be thicker in the viewing area while still fitting in the enclosure.

The sheet can have a plastic film on it for protection while shipping to the customer. The protective film will be die cut before machining.
