PaxInstruments/t400-enclosure/graphics/buttons/t400-silicone-buttons-right-assembly.PDF

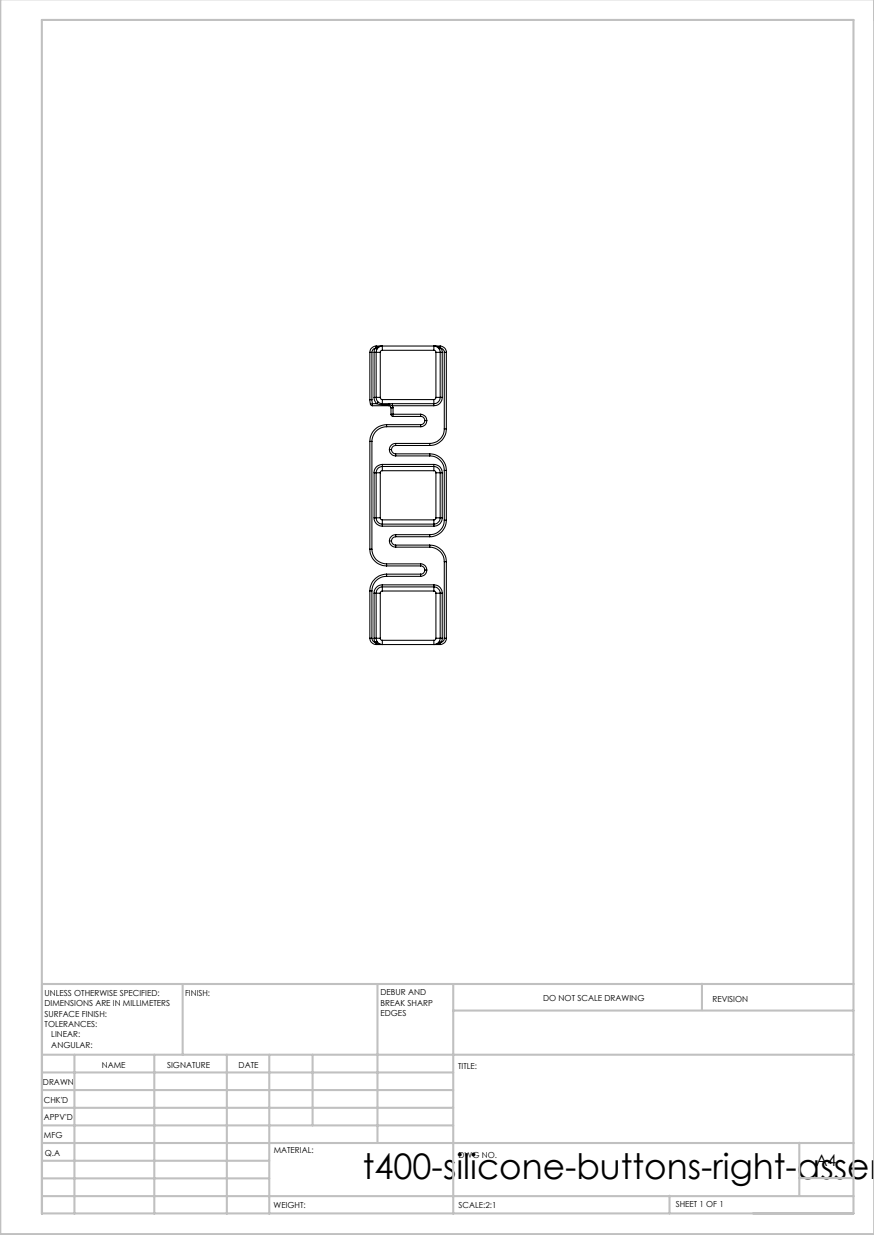
[picture p41: page 1]
SCALE:2:1; SHEET 1 OF 1; DO NOT SCALE DRAWING; REVISION; DEBUR AND BREAK SHARP; UNLESS OTHERWISE SPECIFIED:; FINISH:

DIMENSIONS ARE IN MILLIMETERS
SURFACE FINISH:
TOLERANCES:
LINEAR:
ANGULAR:

NAME | SIGNATURE | DATE | | | | TITLE:
Q.A | | | | t400-silicone-buttons-right-assembly WEIGHT: MATERIAL: | DWG NO. | A4

DRAWN
CHK'D
APPV'D
MFG
