PaxInstruments/t400-enclosure/graphics/buttons/button_label_measurement_specifications.pdf

# Button Specifications

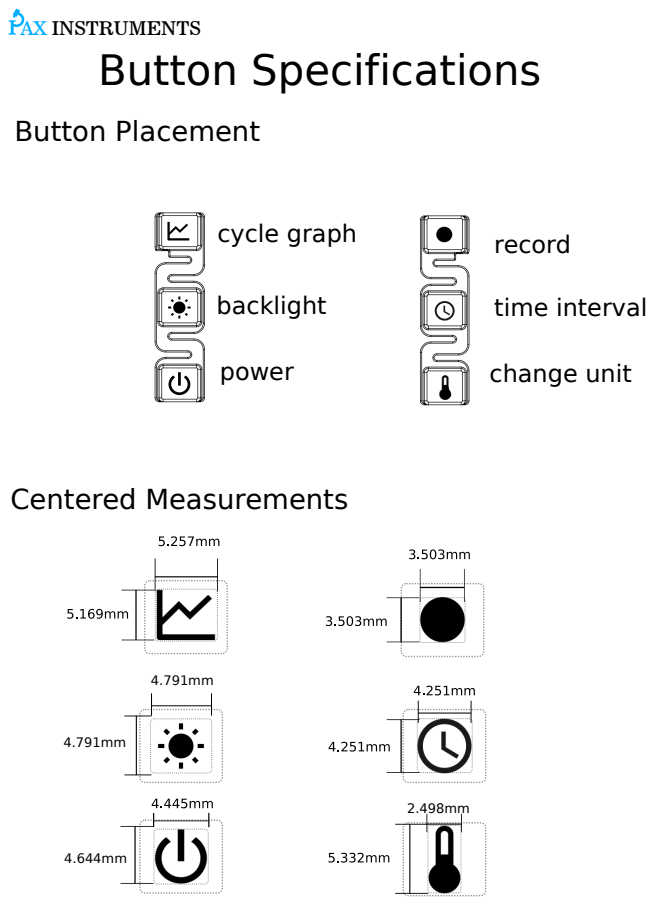
[picture p42: page 1]
AX INSTRUMENTS; Button Placement; cycle graph; backlight; power; time interval; record; change unit; Centered Measurements
