PaxInstruments/t400-enclosure/Injection Molded/t400-window.PDF

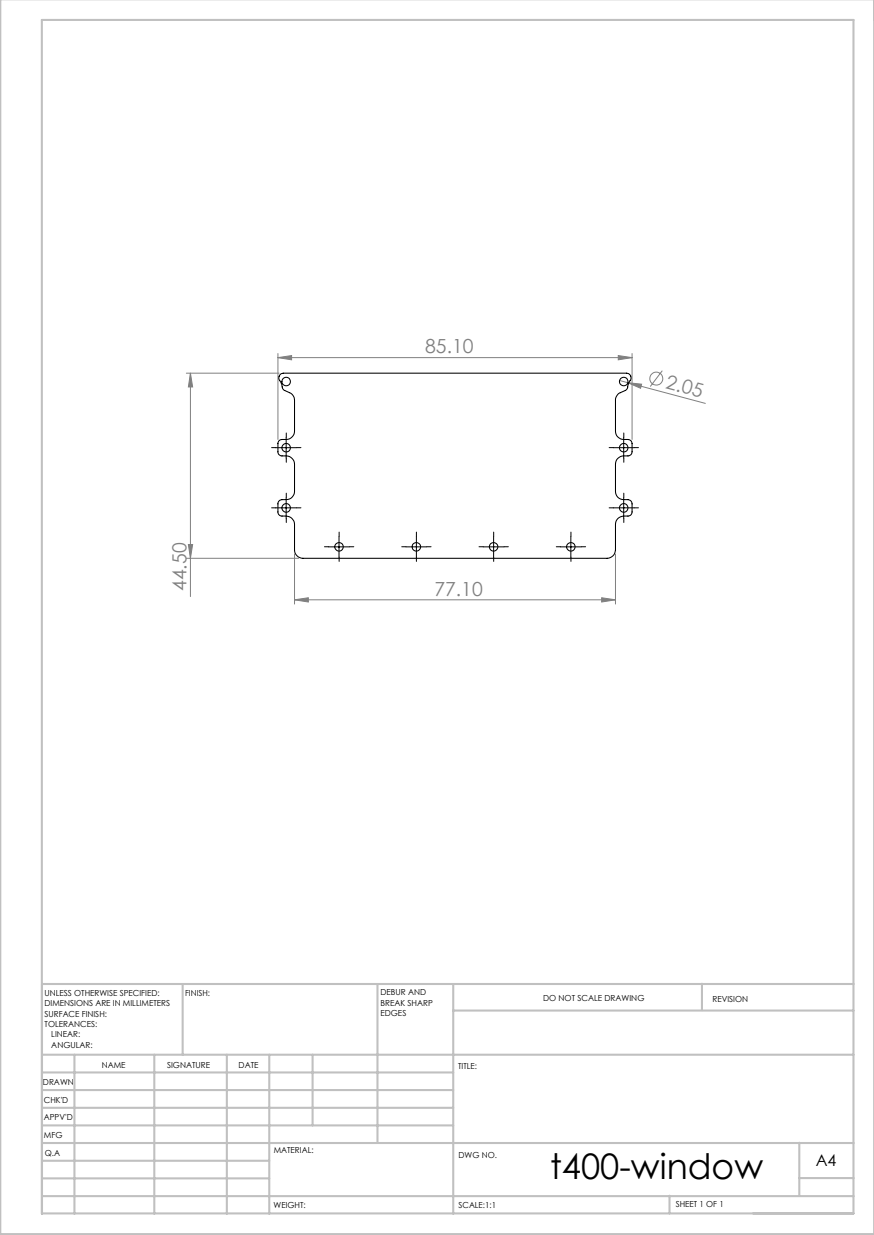
[picture p43: page 1]
SCALE:1:1; SHEET 1 OF 1; DO NOT SCALE DRAWING; REVISION; DEBUR AND BREAK SHARP; UNLESS OTHERWISE SPECIFIED:; FINISH:

DIMENSIONS ARE IN MILLIMETERS
SURFACE FINISH:
TOLERANCES:
LINEAR:
ANGULAR:

NAME | SIGNATURE | DATE | | | | TITLE:
Q.A | | | | MATERIAL: | t400-window WEIGHT: DWG NO. | A4

DRAWN
CHK'D
APPV'D
MFG
