PaxInstruments/t400-enclosure/graphics/front label/v2/t400-front-label-v2.pdf

# Pax Instruments T400 Front Label

T400

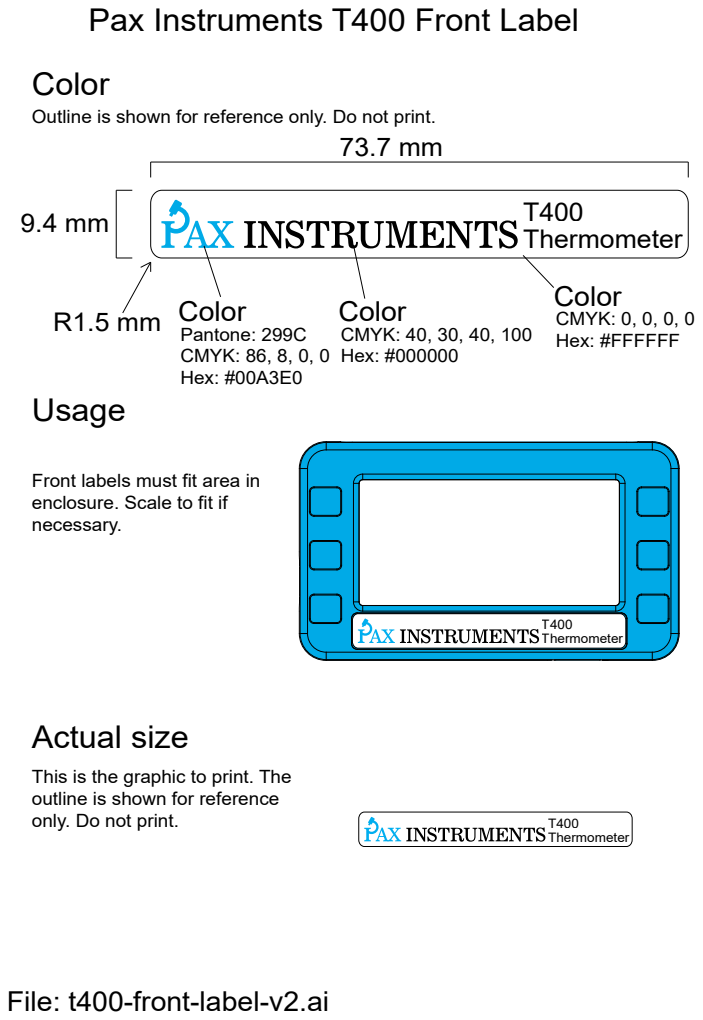
[picture p44: page 1]
Usage; Thermometer; R1.5 mm Color Pantone: 299C CMYK: 86, 8, 0, 0 Hex: #00A3E0; Color CMYK: 40, 30, 40, 100 Hex: #000000; Color CMYK: 0, 0, 0, 0 Hex: #FFFFFF; T400 Thermometer; Actual size

Color
Outline is shown for reference only. Do not print.

Front labels must fit area in
enclosure. Scale to fit if
necessary.

This is the graphic to print. The
outline is shown for reference
only. Do not print.

File: t400-front-label-v2.ai
