PaxInstruments/t400-enclosure/(commit log)

2014-08-11 - Enclosure for board revision 0.6
    [t400-enclosure-back.STL, t400-enclosure-back.sldprt, t400-enclosure-front.STL, t400-enclosure-front.sldprt, t400-enclosure-tc-panel.STL, t400-enclosure-tc-panel.sldprt, t400-enclosure.sldprt]
2014-08-15 - Starting work on enclosure for board version 0.8 - Moved MicroSD port down - Moved buttons - added .gitignore
    [t400-enclosure.sldprt]
2014-08-24 - Added manual supports for the battery compartment
    [t400-enclosure-back.STL, t400-enclosure-back.sldprt, t400-enclosure-front.STL, t400-enclosure-front.sldprt, t400-enclosure-tc-panel.STL, t400-enclosure-tc-panel.sldprt, t400-enclosure.sldprt]
2014-08-26 - Added a buttons files. Incorporate this with t400-enclosure.sldprt
    [t400-buttons.sldprt, t400-enclosure-back.STL, t400-enclosure-back.sldprt, t400-enclosure.sldprt]
2014-09-01 - Battery snaps in. No cover.
    [t400-enclosure-back.STL, t400-enclosure-back.sldprt, t400-enclosure-front.STL, t400-enclosure-front.sldprt, t400-enclosure-tc-panel.STL, t400-enclosure-tc-panel.sldprt, t400-enclosure.sldprt]
2014-11-03 First draft of inline tilting bail for production units
    [PI-t400-master-rev1.SLDPRT]
2014-11-03 Revert "First draft of inline tilting bail for production units"
    This reverts commit 665fd0d6b4a562ed015ad075335407c2339e255b.
    [PI-t400-master-rev1.SLDPRT]
2014-11-11 added battery notches, changed clearances for easier installation
    [PI-t400-master-rev1.SLDPRT]
2014-11-20 Moved original 3D printed enclosure to 3D Printed directory
    [t400-buttons.sldprt, t400-enclosure-back.STL, t400-enclosure-back.sldprt, t400-enclosure-front.STL, t400-enclosure-front.sldprt, t400-enclosure-tc-panel.STL, t400-enclosure-tc-panel.sldprt, t400-enclosure.sldprt]
2014-11-20 Removed Inline tilting bail directory
    [PI-t400-master-rev1.SLDPRT]
2014-11-20 Added Injection Molded directory, exported draft of all bodies
    [t400-back.sldprt, t400-bail.sldprt, t400-battery-cover.sldprt, t400-front.sldprt, t400-master.SLDPRT, t400-pcb.sldprt, t400-top.sldprt, t400-window.sldprt]
2014-11-20 Added assembly for verifying bail geometry
    [t400-assembled.SLDASM]
2014-11-20 Fixed broken external references from master file
    [t400-assembled.SLDASM, t400-back.sldprt, t400-bail.sldprt, t400-battery-cover.sldprt, t400-front.sldprt, t400-master.SLDPRT, t400-pcb.sldprt, t400-top.sldprt]
2014-11-24 added silicone buttons
    [t400-master.SLDPRT]
2014-11-24 added silicone parts to assembled unit
    [t400-assembled.SLDASM, t400-back.sldprt, t400-bail.sldprt, t400-battery-cover.sldprt, t400-front.sldprt, t400-master.SLDPRT, t400-pcb.sldprt, t400-silicone-buttons.sldprt]
2014-12-01 refined structural ribs on front
    [t400-front.sldprt]
2014-12-01 added structural ribs to back, fixednominal thickness
    [t400-back.sldprt]
2014-12-01 updated assembly with new back front and buttons
    [t400-assembled.SLDASM, t400-bail.sldprt, t400-battery-cover.sldprt, t400-pcb.sldprt, t400-silicone-buttons.sldprt, t400-top.sldprt, t400-window.sldprt]
2014-12-01 updated assembly with issue #3 and #4
    [t400-assembled.SLDASM, t400-back.sldprt, t400-bail.sldprt, t400-battery-cover.sldprt, t400-front.sldprt, t400-pcb.sldprt, t400-silicone-buttons.sldprt, t400-top.sldprt]
2014-12-05 battery cover and bail rework
    [t400-assembled.SLDASM, t400-back.sldprt, t400-bail.sldprt, t400-battery-cover.sldprt, t400-front.sldprt, t400-pcb.sldprt, t400-silicone-buttons.sldprt, t400-top.sldprt]
2014-12-08 battery cover and bail refinement
2014-12-08 added draft and rounds to top
    [t400-top.sldprt]
2014-12-08 added drafts and rounds to back
    [t400-back.sldprt]
2014-12-08 added drafts and rounds to front
    [t400-front.sldprt]
2014-12-08 drafted battery cover and bail
    [t400-bail.sldprt, t400-battery-cover.sldprt]
2014-12-08 updated assembly with all latest files
    [t400-assembled.SLDASM, t400-pcb.sldprt, t400-silicone-buttons.sldprt, t400-window.sldprt]
2014-12-10 Fixed thin wall from draft on front lip
    [t400-assembled.SLDASM, t400-back.sldprt, t400-bail.sldprt, t400-battery-cover.sldprt, t400-front.sldprt, t400-pcb.sldprt, t400-silicone-buttons.sldprt, t400-top.sldprt]
2014-12-10 removed some material from top channel to enable larger working area
2014-12-10 added numbers in top plastic to label inputs
    [t400-top.sldprt]
2014-12-10 added 1mm to overall thickness, fixing battery cover tolerances
    [t400-assembled.SLDASM, t400-back.sldprt, t400-bail.sldprt, t400-battery-cover.sldprt, t400-front.sldprt, t400-pcb.sldprt, t400-silicone-buttons.sldprt, t400-top.sldprt]
2014-12-13 Strengthened the bail, resized M2 features to fit threaded inserts and screws
    [t400-assembled.SLDASM, t400-back.sldprt, t400-bail.sldprt, t400-battery-cover.sldprt, t400-front.sldprt, t400-pcb.sldprt, t400-silicone-buttons.sldprt, t400-top.sldprt]
2014-12-15 added larger skirt to silicone buttons (issue #25)
    [t400-assembled.SLDASM, t400-back.sldprt, t400-bail.sldprt, t400-battery-cover.sldprt, t400-front.sldprt, t400-pcb.sldprt, t400-silicone-buttons.sldprt, t400-top.sldprt]
2014-12-15 Updated battery connector location
    https://github.com/PaxInstruments/t400-electronics/issues/83
    [t400-assembled.SLDASM, t400-back.sldprt, t400-bail.sldprt, t400-battery-cover.sldprt, t400-front.sldprt, t400-pcb.sldprt, t400-silicone-buttons.sldprt, t400-top.sldprt]
2014-12-15 Added new thermocouple connectors to PCB, added guides for thermocouple probes in top (issue #18)
    thermocouple connector:
    https://github.com/PaxInstruments/t400-electronics/issues/93
    [t400-assembled.SLDASM, t400-bail.sldprt, t400-battery-cover.sldprt, t400-front.sldprt, t400-pcb.sldprt, t400-silicone-buttons.sldprt, t400-top.sldprt, t400-window.sldprt]
2014-12-15 Reduced the thickness of inner ribs on all parts from 1.6mm to 1.3mm
    [t400-assembled.SLDASM, t400-bail.sldprt, t400-battery-cover.sldprt, t400-front.sldprt, t400-pcb.sldprt, t400-silicone-buttons.sldprt, t400-top.sldprt, t400-window.sldprt]
2014-12-15 Made bail snaps round, added inclined surfaces for easier installations
    [t400-assembled.SLDASM, t400-back.sldprt, t400-bail.sldprt, t400-battery-cover.sldprt, t400-front.sldprt, t400-pcb.sldprt, t400-silicone-buttons.sldprt, t400-top.sldprt]
2014-12-15 Added punch-out panels for easy access to i/o and programming pads
    [t400-assembled.SLDASM, t400-back.sldprt]
2014-12-15 Moved the punch-out panels to a better location
    [t400-assembled.SLDASM, t400-back.sldprt]
2014-12-15 Added melt ribs to hold window in place, extended window to fit in front of LCD more securely
    [t400-assembled.SLDASM, t400-back.sldprt, t400-bail.sldprt, t400-battery-cover.sldprt, t400-front.sldprt, t400-pcb.sldprt, t400-silicone-buttons.sldprt, t400-top.sldprt]
2014-12-15 Added temp wall in front of SD for cutting and measuring SD slot gap with SLA prototypes
    [t400-front.sldprt]
2014-12-15 Adjusted punch-out panels to be accessible from inside only
    [t400-back.sldprt]
2014-12-15 Added polarity to top thermocouple slots, fixed issue #30
    [t400-assembled.SLDASM, t400-back.sldprt, t400-bail.sldprt, t400-battery-cover.sldprt, t400-front.sldprt, t400-pcb.sldprt, t400-silicone-buttons.sldprt, t400-top.sldprt]
2014-12-26 Increased size of chamfers for M2 countersunk screws (fixes issue #40)
2014-12-26 Increased size of flex relief notches between silicone buttons (fixes issue #45)
2014-12-26 Removed ribs that interfere with LCD cable (fixes issue #38)
2014-12-26 Center justified top thermocouple channel numbers (fixes issue #43)
    [t400-top.sldprt]
2014-12-26 Closed open ceiling above battery connector on back cover (fixes issue #52)
    [t400-assembled.SLDASM, t400-back.sldprt, t400-bail.sldprt, t400-battery-cover.sldprt, t400-front.sldprt, t400-pcb.sldprt, t400-silicone-buttons.sldprt, t400-top.sldprt]
2014-12-27 Updated SD card to latest connector (attempting to resolve issue #53)
    [t400-assembled.SLDASM, t400-back.sldprt, t400-bail.sldprt, t400-battery-cover.sldprt, t400-front.sldprt, t400-pcb.sldprt, t400-silicone-buttons.sldprt, t400-top.sldprt]
2015-01-02 changed SD overhang distance to 0.79mm (fixes issue #53)
2015-01-02 Removed temp wall on front, changed SD card overhang to 0.7mm from PCB (re-fixes issue #53)
    [t400-front.sldprt]
2015-01-02 Added experimental bail files (referred to in issue #60)
    [bail-experimental-master.SLDPRT, bail-experimental.SLDPRT, battery-cover-experimental.sldprt, experimental-bail-assembly.SLDASM]
2015-01-12 slightly increased silicone button face height to perfectly align over mechanical switches
2015-01-13 Updated new bail files
    [bail-experimental-master.SLDPRT, bail-experimental.SLDPRT, battery-cover-experimental.sldprt, experimental-bail-assembly.SLDASM]
2015-01-14 fully integrated new bail into master file
    [bail-experimental-master.SLDPRT, experimental-bail-assembly.SLDASM]
2015-01-14 removed previous nubs from back, exported all parts, resolved lingering relationship errors
    [t400-BL5C-battery.sldprt, t400-assembled.SLDASM, t400-back.sldprt, t400-bail.sldprt, t400-battery-cover.sldprt, t400-front.sldprt, t400-pcb.sldprt, t400-silicone-buttons.sldprt]
2015-01-15 Removed experimental bail directory after merging into master file
    [bail-experimental-master.SLDPRT, bail-experimental.SLDPRT, battery-cover-experimental.sldprt, experimental-bail-assembly.SLDASM]
2015-01-16 Added debossed battery info to back (fixes issue #24)
    [t400-back.sldprt]
2015-01-16 Added 0.25mm clearance between battery and positioning features
2015-01-16 Added 0.25mm clearance between battery and positioning features (fixes issue #33)
2015-01-16 Tightened up fit around enclosure top, made top wider for easier assembly (fixes issue #34)
    [t400-front.sldprt, t400-top.sldprt]
2015-01-16 tightened fit around bottom side of LCD (for issue #37)
2015-01-16 Tightened clearance on outer lip between top and bottom of enclosure (fixes issue #41)
    [t400-front.sldprt]
2015-01-17 Changed boss shoulder configuration (fixes issue #64)
    [t400-assembled.SLDASM, t400-bail.sldprt, t400-battery-cover.sldprt, t400-front.sldprt, t400-pcb.sldprt, t400-silicone-buttons.sldprt, t400-top.sldprt, t400-window.sldprt]
2015-01-22 Reworked window stackup for melt-able riveting (fixes issue#50)
    [t400-BL5C-battery.sldprt, t400-assembled.SLDASM, t400-bail.sldprt, t400-battery-cover.sldprt, t400-front.sldprt, t400-pcb.sldprt, t400-silicone-buttons.sldprt, t400-top.sldprt]
2015-01-22 adjusted chamfer window bezel (to address issue#58)
    [t400-front.sldprt]
2015-01-22 tightened clearance around battery cover (fixes issue #32)
    [t400-battery-cover.sldprt]
2015-01-22 Added appropriate height to buttons, removed material from silicone to rest on buttons (fixes issue #62)
    [t400-silicone-buttons.sldprt]
2015-01-22 Added fasteners to assembly
    [t400-assembled.SLDASM, t400-bail.sldprt, t400-battery-cover.sldprt, t400-fastener-m2x10.SLDPRT, t400-fastener-m2x24.SLDPRT, t400-fastener-threaded-insert.SLDPRT, t400-front.sldprt, t400-pcb.sldprt]
2015-01-23 Graphics
    - Added a folder with logo graphics.
    [logo.dxf]
2015-01-23 added clearance between silicone buttons and usb connector (fixes issue #62)
    [t400-front.sldprt, t400-silicone-buttons.sldprt]
2015-01-24 Cleaned up the new bail a bit
    [t400-bail.sldprt]
2015-01-24 added battery to assembly, fixed hinge angle
    [t400-BL5C-battery.sldprt, t400-bail.sldprt, t400-battery-cover.sldprt, t400-pcb.sldprt, t400-silicone-buttons.sldprt, t400-top.sldprt, t400-window.sldprt]
2015-01-24 added battery to assembly, finished up drafts on bail assembly
    [makeProjectedPlanarWire.x_t, t400-BL5C-battery.sldprt, t400-assembled.SLDASM, t400-bail.sldprt, t400-battery-cover.sldprt, t400-pcb.sldprt, t400-silicone-buttons.sldprt, t400-top.sldprt]
2015-01-26 Tightened clearance around bottom of LCD, removed rounds from base of positioning ribs. (fixes issue #37)
2015-01-26 Added height to silicone buttons (fixes issue #55)
    [t400-silicone-buttons.sldprt]
2015-01-30 Skimmed some material off of the wall behind the battery to get an even 2mm gap from the pcb back (fixes issue #22 and #56)
    [t400-BL5C-battery.sldprt, t400-assembled.SLDASM, t400-bail.sldprt, t400-battery-cover.sldprt, t400-pcb.sldprt, t400-silicone-buttons.sldprt, t400-top.sldprt, t400-window.sldprt]
2015-02-01 added height to mechanical buttons, added clearance to silicone button depressions (fixes issue #78)
2015-02-01 added 0.5mm to USB connector opening to avoid interference (fixes issue #81)
2015-02-01 shifted SD card within connector to match location in real life connector (fixes issue #79)
2015-02-01 Added locating features when assembling PCB (fixes issue #80)
    [t400-silicone-buttons.sldprt]
2015-02-01 reverted original usb inlet geometry and added chamfer to enclosure wall instead. removed left sided locating features (fixes issue #80)
    [t400-pcb.sldprt]
2015-02-02 Added underside support for bail on battery cover (fixes issue #70)
    [t400-battery-cover.sldprt]
2015-02-02 tightened up clearance around bail, added an extended surface to the underside, and made sure there is interefence when bail locked open
    [t400-bail.sldprt, t400-battery-cover.sldprt]
2015-02-02 added features to top so it can only be inserted in one direction, made numbers larger (fixes issue #73 and issue #67)
    [t400-BL5C-battery.sldprt, t400-assembled.SLDASM, t400-bail.sldprt, t400-battery-cover.sldprt, t400-pcb.sldprt, t400-silicone-buttons.sldprt, t400-top.sldprt, t400-window.sldprt]
2015-03-18 bail stronger, added another stopping surface, snaps longer and bail is never released from track. (fix at issue #85, #86, #87) still issue
    [t400-battery-cover.sldprt]
2015-03-18 cleaned up errors in initial bail update
    [t400-BL5C-battery.sldprt, t400-assembled.SLDASM, t400-back.sldprt, t400-bail.sldprt, t400-battery-cover.sldprt, t400-pcb.sldprt, t400-silicone-buttons.sldprt, t400-top.sldprt]
2015-03-19 re-exported and saved files (fixes issue #83)
    [t400-BL5C-battery.sldprt, t400-assembled.SLDASM, t400-back.sldprt, t400-bail.sldprt, t400-battery-cover.sldprt, t400-front.sldprt, t400-pcb.sldprt, t400-silicone-buttons.sldprt]
2015-03-20 fixed bail fillet quirk, increased bail snap angle to 42deg. from center, opened up chamfer on lock positions (fixes issues #89, #85, #91)
    [t400-bail.sldprt]
2015-03-20 added thermo-clip, updated pcba, moved holes in top to match (fixes issue #88)
    [t400-BL5C-battery.sldprt, t400-assembled.SLDASM, t400-back.sldprt, t400-bail.sldprt, t400-battery-cover.sldprt, t400-front.sldprt, t400-pcb.sldprt, t400-pcba.SLDASM]
2015-03-20 added 3rd top panel assembly peg (fixes issue #67)
    [t400-BL5C-battery.sldprt, t400-assembled.SLDASM, t400-back.sldprt, t400-bail.sldprt, t400-battery-cover.sldprt, t400-front.sldprt, t400-pcb.sldprt, t400-pcba.SLDASM]
2015-03-23 Added button graphics svg worksheet.
2015-03-23 Added final layer of buttons worksheet and exported it to png.
2015-03-23 Added label with 'Temperature Datalogger', and put 'T400' to the right.
2015-03-25 changed dementions of label and document to 72mm x 7.5mm.
2015-03-25 Made changes to buttons taking part from google icon set.
2015-03-26 Made a svg for each button, and exported each button at 600dpi.
2015-03-29 enclosure 0.4
    [t400-BL5C-battery.sldprt, t400-assembled.SLDASM, t400-bail.sldprt, t400-battery-cover.sldprt, t400-front.sldprt, t400-pcb.sldprt, t400-pcba.SLDASM, t400-silicone-buttons.sldprt]
2015-03-29 Fixed SD slot positioning, added ribs to prevent losing SD inside enclosure (fixes issues #96, #98)
    [t400-BL5C-battery.sldprt, t400-assembled.SLDASM, t400-bail.sldprt, t400-battery-cover.sldprt, t400-pcb.sldprt, t400-pcba.SLDASM, t400-silicone-buttons.sldprt, t400-top.sldprt]
2015-03-29 maxed out height on PCB locating ribs for easier assembly (fixes issue #99)
2015-03-29 Derived a left and right version of the silicone buttons (fixes issue #100)
    [t400-silicone-buttons-left-assembly.SLDPRT, t400-silicone-buttons-right-assembly.SLDPRT, t400-silicone-buttons.sldprt]
2015-03-29 added left and right button versions to assembly
    [t400-BL5C-battery.sldprt, t400-assembled.SLDASM, t400-bail.sldprt, t400-battery-cover.sldprt, t400-pcb.sldprt, t400-pcba.SLDASM, t400-top.sldprt, t400-window.sldprt]
2015-04-01 Used buttons worksheet to layout measurement specifications.
2015-04-01 Added pdf of button measurments.
2015-04-04 Changed button to black on white. Added bounding box measurements. Exported it to a pdf.
2015-04-05 change button dimentions, for some reason the bounding box of the circle was not square. Also removed a redundent file called cycle_graph.svg.
2015-04-05 Updated button line drawings images.
    [t400-silicone-buttons-right-assembly.DXF]
2015-04-05 Changed button to new version.
2015-04-06 Made butoon power and backlight square.
2015-04-06 Reverted power button back to old dimensions.
2015-04-24 created E9 style connector
    [t400-thermo-clip2.SLDPRT]
2015-04-24 added E9 connectors to PCBA
    [t400-pcba.SLDASM]
2015-04-25 Changed the TC connector flanges. Set to 30 degrees up, 30 degrees down. 0.75 mm protrusion.
    [t400-thermo-clip2.SLDPRT]
2015-04-29 Added drawing for thermocouple connector.
    [t400-thermo-clip2.DXF, t400-thermo-clip2.SLDDRW, t400-thermo-clip2.SLDPRT]
2015-04-30 Adjusted top panel to allow more surface area of contact with the female connector
    [t400-BL5C-battery.sldprt, t400-assembled.SLDASM, t400-bail.sldprt, t400-battery-cover.sldprt, t400-pcb.sldprt, t400-pcba.SLDASM, t400-silicone-buttons-left-assembly.SLDPRT, t400-silicone-buttons-right-assembly.SLDPRT]
2015-05-04 Added updated connector get final dimensions of overhang on PCB (addresses https://github.com/PaxInstruments/t400-electronics/issues/170)
    [t400-BL5C-battery.sldprt, t400-assembled.SLDASM, t400-battery-cover.sldprt, t400-pcba.SLDASM, t400-thermo-clip2.SLDPRT]
2015-08-08 Added battery polarity markings on enclosure (fixes #104)
2015-08-08 Adjusted button height above front panel surface to be 1mm (fixes #97)
    [t400-silicone-buttons-left-assembly.SLDPRT, t400-silicone-buttons-right-assembly.SLDPRT]
2015-08-08 Tightened up thermocouple connector hole size to avoid possible interference when inserting (fixes #107)
2015-08-08 Added Lasercut file directory and window dxf (fixes #109)
    [t400-window.DXF]
2015-08-08 updated thermocouple connector model to match real life (fixes #110)
    [t400-thermo-clip2.SLDPRT]
2015-08-08 adjusted logo sticker depth to 0.4mm so the sticker stays recessed at all times (fixes #108)
2015-08-10 Reverted latest change on silicone buttons since they are already made (issue #97)
2015-08-10 Saved out all files for enclosure 0.5 pull request
    [t400-BL5C-battery.sldprt, t400-assembled.SLDASM, t400-bail.sldprt, t400-battery-cover.sldprt, t400-pcb.sldprt, t400-pcba.SLDASM, t400-silicone-buttons-left-assembly.SLDPRT, t400-silicone-buttons-right-assembly.SLDPRT]
2015-08-11 Renamed thermoclip file I made, so we can move to Starno's.
    [t400-thermo-clip2_pax.DXF, t400-thermo-clip2_pax.SLDDRW, t400-thermo-clip2_pax.SLDPRT]
2015-08-18 added 2 ribs above sd slot to ensure it cant fall into case (fixes #115)
2015-08-18 tightened up clearance around SD slot (fixes #119)
2015-08-18 added 3 structural ribs on back threaded insert boss (attempt at fixing #122)
2015-08-18 added 4th rib to threaded insert boss, shifted thermocouple panel keyway over 12mm from center (fixes #122)
    [t400-top.sldprt]
2015-08-19 modified USB hole (and SD slot) to no look so blocky (fixes issue #123)
    [t400-top.sldprt]
2015-08-26 updated winged bail design to have larger nub and stronger reinforcement when open (option 1 for issue #121)
    [t400-bail.sldprt, t400-battery-cover.sldprt]
2015-08-27 added alternate bail (wingless, with locking features on axis) into alternate bail directory (issue #121)
    [Assem2.SLDASM, t400-bail-2.sldprt, t400-battery-cover-2.SLDPRT]
2015-08-27 widened snaps on alternate tilting bail to distribute wear (fixes issue #129)
    [t400-battery-cover-2.SLDPRT]
2015-08-27 made the fillets on the SD slot tab concentric with the fillets on the opposite side (fixes issue #126)
2015-09-03 Chamfered on wing bail wing tip, closes #133. Added chamger on bail blocker, closes #144.
    [t400-bail.sldprt]
2015-09-03 Removed interference issue. Closes #131. Fixed wing slots. Closes #132.
    [t400-BL5C-battery.sldprt, t400-assembled.SLDASM, t400-bail.sldprt, t400-battery-cover.sldprt, t400-pcb.sldprt, t400-pcba.SLDASM, t400-silicone-buttons-left-assembly.SLDPRT, t400-silicone-buttons-right-assembly.SLDPRT]
2015-09-03 Modified USB hole. Closes #137.
    [t400-BL5C-battery.sldprt, t400-assembled.SLDASM, t400-bail.sldprt, t400-battery-cover.sldprt, t400-pcb.sldprt, t400-pcba.SLDASM, t400-silicone-buttons-left-assembly.SLDPRT, t400-silicone-buttons-right-assembly.SLDPRT]
2015-09-22 Modified enclosure window. Closes #141 closes #143.
    [t400-BL5C-battery.sldprt, t400-assembled.SLDASM, t400-bail.sldprt, t400-battery-cover.sldprt, t400-pcb.sldprt, t400-pcba.SLDASM, t400-silicone-buttons-left-assembly.SLDPRT, t400-silicone-buttons-right-assembly.SLDPRT]
2015-09-22 Removed the old lasercut window file.
    [t400-window.DXF]
2015-09-22 Added a PDF of the window drawing.
    [t400-window.SLDDRW]
2015-09-25 Added STEP and STL files for Milestone 7.
    [t400-assembled.SLDASM, t400-bail.STEP, t400-bail.STL, t400-battery-cover.STEP, t400-battery-cover.STL, t400-pcba.SLDASM, t400-top.STEP, t400-top.STL]
2015-10-08 Added heat stakes to top corners of LCD, closes #160. Increased heat stake diameter, closes #161. Decreased MicroSD card slot size, closes #155.
2015-10-09 Added chamfers. Covered battery connector, closes #162.
2015-10-10 Removed fillet on top panel outter edge, closes #165.
    [t400-top.sldprt]
2015-10-10 Added files for the front panel label. It is not complete.
    [t400-label-front.SLDDRW, t400-label-front.SLDPRT]
2015-10-15 Closed back hole for threaded insert, closes #172.
    [t400-back.sldprt]
2015-10-15 Added some draft.
    [t400-top.sldprt]
2015-10-15 Added graphic elements. Saved all solidworks files, one had been inrollback state.
    [t400-BL5C-battery.sldprt, t400-assembled.SLDASM, t400-bail.sldprt, t400-battery-cover.sldprt, t400-label-front.DXF, t400-pcb.sldprt, t400-pcba.SLDASM, t400-silicone-buttons-left-assembly.SLDPRT]
2015-10-15 Added milestone 9 STP files.
    [t400-bail.STEP, t400-battery-cover.STEP, t400-front.STEP, t400-top.STEP]
2015-10-30 Added a sample cavity of the front.
2015-11-08 Changed drafting. Added sample mold. Front, back, and top are done.
2015-11-09 Version 10 t-400 master file. This may change when the Battery Cover and Tiling Bail are finished.
2015-11-09 Modified some drafting. Make a mold for the battery cover.
    [t400-BL5C-battery.sldprt, t400-pcb.sldprt, t400-pcba.SLDASM, t400-silicone-buttons-left-assembly.SLDPRT, t400-silicone-buttons-right-assembly.SLDPRT, t400-window.sldprt]
2015-11-13 Deleted STL and STP files from old versions.
    [t400-bail.STEP, t400-bail.STL, t400-battery-cover.STEP, t400-battery-cover.STL, t400-front.STEP, t400-top.STEP, t400-top.STL]
2015-12-19 Updated Window to include the upper left and upper right heat stakes.
    [t400-window.DXF, t400-window.SLDDRW, t400-window.sldprt]
2015-12-21 Updated from panel label. reorganized graphics files.
    [logo.dxf, t400-front-label-v2.dxf, t400-front.DXF, t400-silicone-buttons-right-assembly.DXF]
